sufzoli/suf-electronics-fc002/FC002B (Production PCB)/Documentation/PIC/FC002_conn.jpg

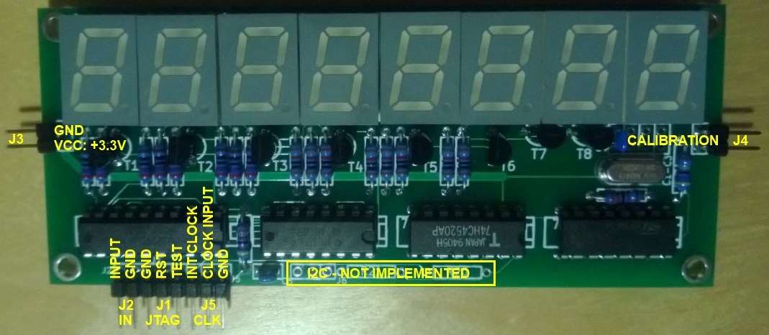
FC002B (Production PCB)/Documentation/PIC/FC002_conn.jpg
