sufzoli/suf-electronics-fc002/FC002B (Production PCB)/Documentation/PIC/FC002_small.jpg

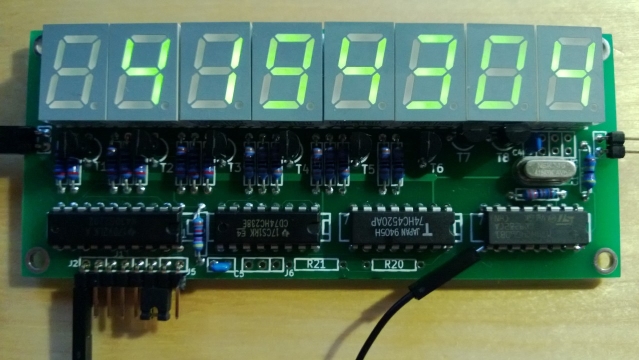
FC002B (Production PCB)/Documentation/PIC/FC002_small.jpg
