sufzoli/suf-electronics-fc002/README.md

electronics-fc002
=================

MSP430 Based Simple Frequency Counter
