sufzoli/suf-electronics-fc002/Documentation/FC003-conn.jpg

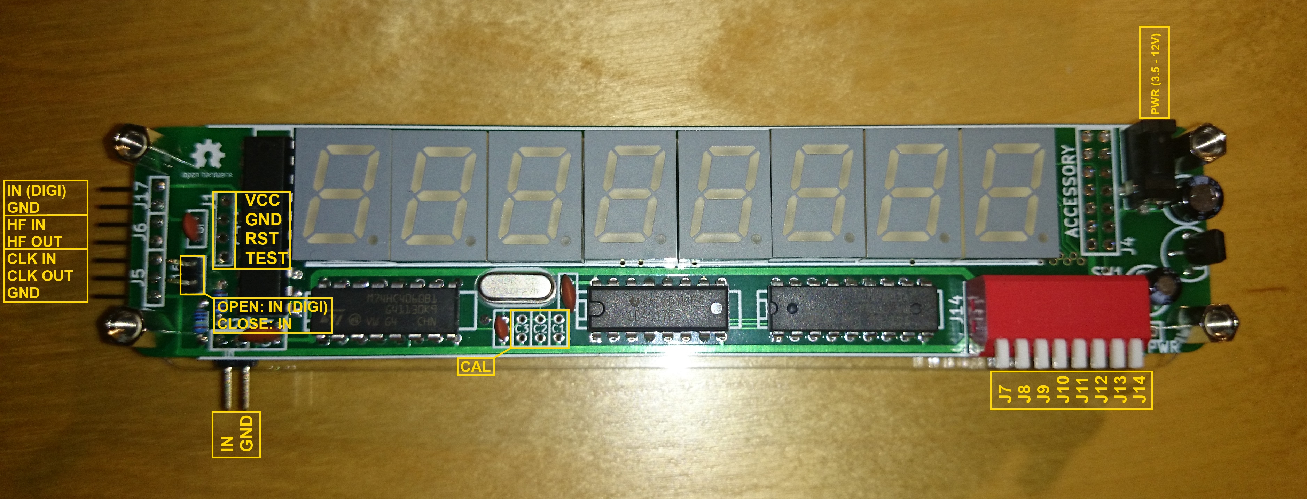
Documentation/FC003-conn.jpg
