sufzoli/suf-electronics-fc002/Documentation/Launchpad.jpg

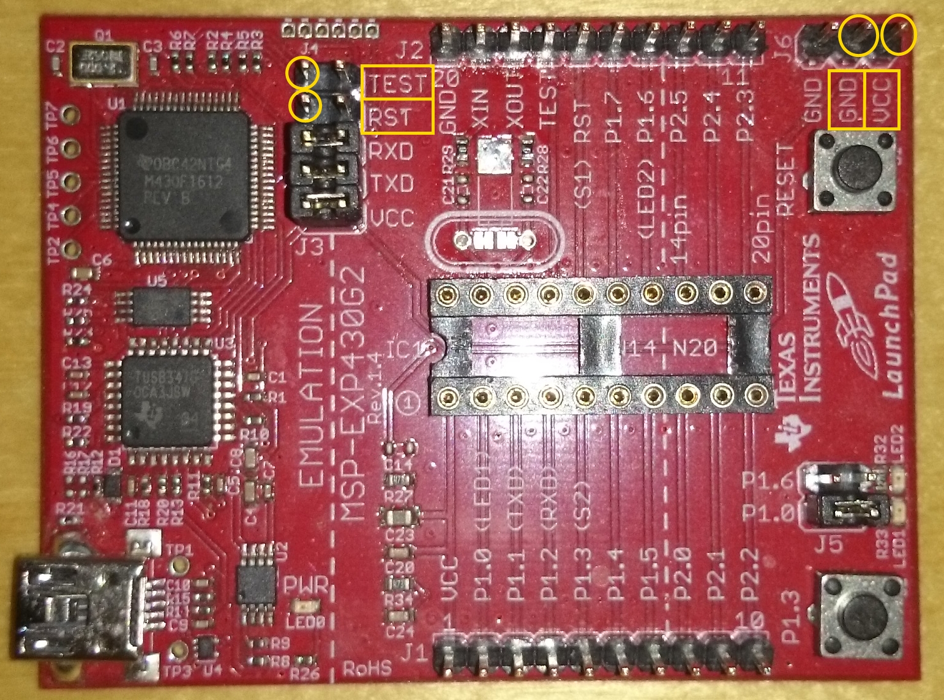
Documentation/Launchpad.jpg
