sufzoli/suf-electronics-fc002/Documentation/page3.gif

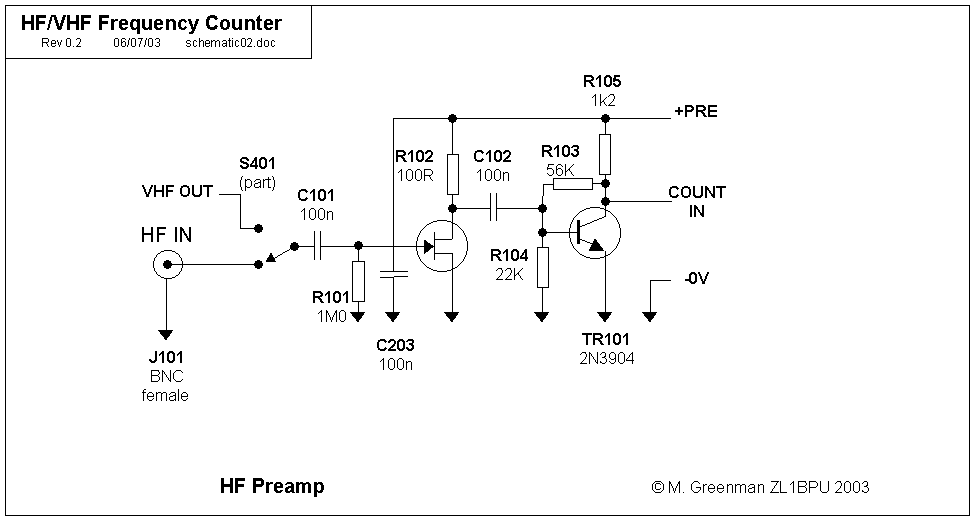
Documentation/page3.gif
