sufzoli/suf-electronics-fc002/Documentation/FC002_component_cost_HUF.xlsx

Sheet: FR002
REF | Value
C1
C2
C3
C4 | 82pF
C5 | 1nF
IC1 | MSP430G2202
IC2 | 74HC238
IC3 | 74HC4060
IC4 | 74HC4520
IC5 | SC52-11
IC6 | SC52-11
IC7 | SC52-11
IC8 | SC52-11
IC9 | SC52-11
IC10 | SC52-11
IC11 | SC52-11
IC12 | SC52-11
J1 | 3 pin Header
J2 | 2 pin Header
J3 | 2 pin Header
J4 | 2 pin Header
J5 | 3 pin Header
R1 | 4M7
R2 | 2K2
R3 | 47K
R4 | 10K
R5 | 10K
R6 | 10K
R7 | 10K
R8 | 10K
R9 | 10K
R10 | 10K
R11 | 10K
R12 | 270
R13 | 270
R14 | 270
R15 | 270
R16 | 270
R17 | 270
R18 | 270
T1 | MPSA43
T2 | MPSA43
T3 | MPSA43
T4 | MPSA43
T5 | MPSA43
T6 | MPSA43
T7 | MPSA43
T8 | MPSA43
X1 | XTAL 4.194304MHz

Sheet: Sheet1
Referencia | Érték | DB | Gyártó | Típus | Beszállító | Kód | Egységár | Ár
C1-C3 | 22pF | 1 | Shinny-Space | SSM15N220J50C | Lomex | 07-09-66 | 10.82 Ft | 10.82 Ft
C4 | 82pF | 1 | Shinny-Space | SSM15N820J50C | Lomex | 07-09-70 | 10.95 Ft | 10.95 Ft
C5 | 1nF | 1 | Shinny-Space | SSM15X102K50C | Lomex | 07-03-31 | 10.41 Ft | 10.41 Ft
IC1 | MSP430G2202 | 1 | Texas Instruments | MSP430G2202IN20 | Farnell | 1866857 | 216.55 Ft | 216.55 Ft
IC2 | 74HC238 | 1 | Texas Instruments | CD74HC238E | Lomex | 30-04-55 | 69.09 Ft | 69.09 Ft
IC3 | 74HC4060 | 1 | ST Microelectronic | M74HC4060B1R | Lomex | 30-04-20 | 79.76 Ft | 79.76 Ft
IC4 | 74HC4520 | 1 | Toshiba | TC74HC4520AP | Lomex | 30-05-27 | 18.41 Ft | 18.41 Ft
IC5-IC12 | SC52-11 | 8 | Kingbright | SC52-11GWA | Lomex | 35-00-04 | 51.47 Ft | 411.76 Ft
J1-J5 | 12 pin tüskesor | 1 | T&T Connection | PHSR-40 | Lomex | 43-00-47 | 75.35 Ft | 75.35 Ft
R1 | 4M7 | 1 | Yageo | MF0207 4M70 1% | Lomex | 02-06-93 | 8.95 Ft | 8.95 Ft
R2 | 2K2 | 1 | Yageo | MF0207 2K20 1% | Lomex | 02-01-51 | 6.95 Ft | 6.95 Ft
R3 | 47K | 1 | Yageo | MF0207 47K0 1% | Lomex | 02-01-83 | 6.95 Ft | 6.95 Ft
R4-R11 | 10K | 8 | Yageo | MF0207 10K0 1% | Lomex | 02-01-67 | 2.5 Ft | 20 Ft
R12-R18 | 270R | 7 | Yageo | MF0207 270R 1% | Lomex | 02-01-29 | 2.59 Ft | 18.13 Ft
T1-T8 | MPSA43 | 8 | Motorola | MPSA43 | Lomex | 21-05-15 | 6.77 Ft | 54.16 Ft
X1 | XTAL 4.194304MHz | 1 | Jenjaan Quartek | HC49/S 4.194304MHz | Lomex | 40-01-33 | 46.42 Ft | 46.42 Ft
 |  |  |  |  |  |  |  | 1064.66 Ft
