sufzoli/suf-electronics-fc002/Documentation/FC003_cost.xlsx

Sheet: FC003
 |  | Required component
C1 |  | none
C2 |  | none
C3 |  | none
C4 | 82pF
C5 | 1nF
C6 | 100nF
C7 | 100nF
C8 | 100uF/16V
C9 | 22uF/16V
D1 | 1N4148
D2 | 1N4148
D3 | 1N4148
D4 | 1N4148
D5 | 1N4148
D6 | 1N4148
D7 | 1N4148
D8 | 1N4148
D9 | 1N4148
D10 | 1N4148
J1 | SBW | none
J2 | IN | 90M | 2
J3 | PWR | 90M | 2
J4 | ACCESSORY | F | 7x2
J5 | EXT CLK | 90M | 3 | F
J6 | HF SRC | 90M | 2 | F
J7-J14 | JUMPER Block | 90M | 2x8 | F
J15 | PSU
J16 | EN_PR | M | 2
J17 | IN_DIG | 90M | 2 | F
R1 | 4M7
R2 | 2K2
R3 | 47K
R4 | 1M
R5 | 10K
R12 | 100
R13 | 100
R14 | 100
R15 | 100
R16 | 100
R17 | 100
R18 | 100
R19 | 100
SW1 | DIPSW-8
U1 | MSP430G2202
U2 | CD4017
U3 | 74HC4060
U4 | ULN2803A
U5 | SC52-11
U6 | SC52-11
U7 | SC52-11
U8 | SC52-11
U9 | SC52-11
U10 | SC52-11
U11 | SC52-11
U12 | SC52-11
U13 | TS2950CT
X1 | 4.194304MHz

Sheet: Sheet1
db | 50 |  | Lomex |  |  | TME |  |  | Farnell |  | eBay
C4 | 82pF | 1 |  | 4.62 | 4.62 |  | 2.728 |  |  |  |  | TME/Home
C5 | 1nF | 1 |  | 5.9 | 5.9 |  | 2.138 |  |  |  |  | TME/Home
C6-C7 | 100nF | 2 |  | 5.5 | 11 |  | 2.876 |  |  |  |  | TME/Home
C8 | 100uF/16V | 1 |  | 9.5 | 9.5 |  |  |  |  |  |  | Lomex
C9 | 22uF/16V | 1 |  | 8.2 | 8.2 |  | 6.932 |  |  |  |  | TME/Lomex
D1-D10 | 1N4148 | 10 |  | 1.64 | 16.4 |  | 1.103 |  |  |  |  | TME
J15 | PSU | 1 |  | 31.3 | 31.3 |  |  |  |  |  |  | ?
R1 | 4M7 | 1 |  | 3.45 | 3.45 |  |  |  |  |  |  | Lomex
R2 | 2K2 | 1 |  | 2.7 | 2.7 |  |  |  |  |  |  | Lomex
R3 | 47K | 1 |  | 2.7 | 2.7 |  |  |  |  |  |  | Lomex
R4 | 1M | 1 |  | 2.7 | 2.7 |  |  |  |  |  |  | Lomex
R5 | 1K | 1 |  | 2.7 | 2.7 |  |  |  |  |  |  | Lomex
R12-R19 | 100 | 8 |  | 2.38 | 19.04 |  |  |  |  |  |  | Lomex
SW1 | DIPSW-8 | 1 |  | 137.14 | 137.14 |  | 161.493 |  |  |  |  | Lomex
U1 | MSP430G2312 | 1 |  |  | 0 |  |  |  |  | 213.32 |  | Farnell
U2 | CD4017 | 1 |  | 38.5 | 38.5 |  | 38.729 |  |  |  |  | Lomex
U3 | 74HC4060 | 1 |  | 61.89 | 61.89 |  | 41.855 |  |  |  |  | TME
U4 | ULN2803A | 1 |  | 89.65 | 89.65 |  | 70.821 |  |  |  |  | TME
U5-U13 | SC52-11 | 8 |  | 40.53 | 324.24 |  | 159.527 |  |  |  |  | Lomex
U13 | TS2950CT-3.3 | 1 |  | 37.34 | 37.34 |  | 21.297 | L78L33ABZ |  |  |  | TME | Ellenőrizni a bekötést
X1 | 4.194304MHz | 1 |  | 35.8 | 35.8 |  | 21.311 |  |  |  |  |  | Várni a tesztig (elmegy-e 16MHz-ről)
 |  |  |  |  | 844.77
J2,J3,J5,J6,J17 | Header 90M | 0.275 | 13.75 | 15.38 |  |  |  |  |  |  |  |  |  | 15 db ára osztva 50-el
J5,J6,J17 | Header F 1x7 | 1 | 50.00 |  |  |  | 30.862 | ZL262-7SG |  |  |  | TME
J7-14 | Header 90M dual | 0.2 | 10.00 | 21.8
J7-14 | Header F 2x8 | 1 | 50.00 |  |  |  | 54.32 | ZL262-16DG |  |  |  | TME
J4 | Header F 2x7 | 1 | 50.00 |  |  |  | 28.658 | ZL262-14DG |  |  |  | TME
J16 | Header 2 M | 0.05 | 2.50 |  |  |  |  |  |  |  |  |  |  | Home
 | Jumper | 3 | 150.00 | 2.27
