sufzoli/suf-electronics-fc002/FC002B v2 (Home PCB)/KiCAD/FC002B_BOM.xlsx

ref | value | ref | value
C1 | C | R4 | 4K7
C2 | C | R5 | 4K7
C3 | C | R6 | 4K7
C4 | 82pF | R7 | 4K7
C5 | 1nF | R8 | 4K7
D1 | 1N4148 | R9 | 4K7
D2 | 1N4148 | R10 | 4K7
IC1 | MSP430G2202 | R11 | 4K7
IC2 | 74HC238 | R12 | 270
IC3 | 74HC4060 | R13 | 270
IC4 | 74HC4520 | R14 | 270
IC5 | SC52-11 | R15 | 270
IC6 | SC52-11 | R16 | 270
IC7 | SC52-11 | R17 | 270
IC8 | SC52-11 | R18 | 270
IC9 | SC52-11 | R19 | 1M
IC10 | SC52-11 | R20 | 10k
IC11 | SC52-11 | T1 | MPSA43
IC12 | SC52-11 | T2 | MPSA43
J1 | JTAG | T3 | MPSA43
J2 | IN | T4 | MPSA43
J3 | PWR | T5 | MPSA43
J4 | CAL | T6 | MPSA43
J5 | EXT CLK | T7 | MPSA43
R1 | 4M7 | T8 | MPSA43
R2 | 2K2 | X1 | 4.194304MHz
R3 | 47K
