sufzoli/suf-electronics-fc002/FC003 (Production PCB)/KiCAD/GERBER_SOB/FC003_SOB-Edge_Cuts.dxf

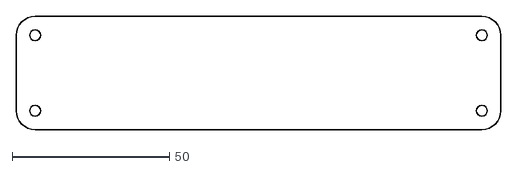
[picture p7: CAD file, 2014-01-21]
FC003 (Production PCB)/KiCAD/GERBER_SOB/FC003_SOB-Edge_Cuts.dxf
154.0 x 36.0
