sufzoli/suf-electronics-fc002/Documentation/FC002B v2 (Home) Schematic.pdf

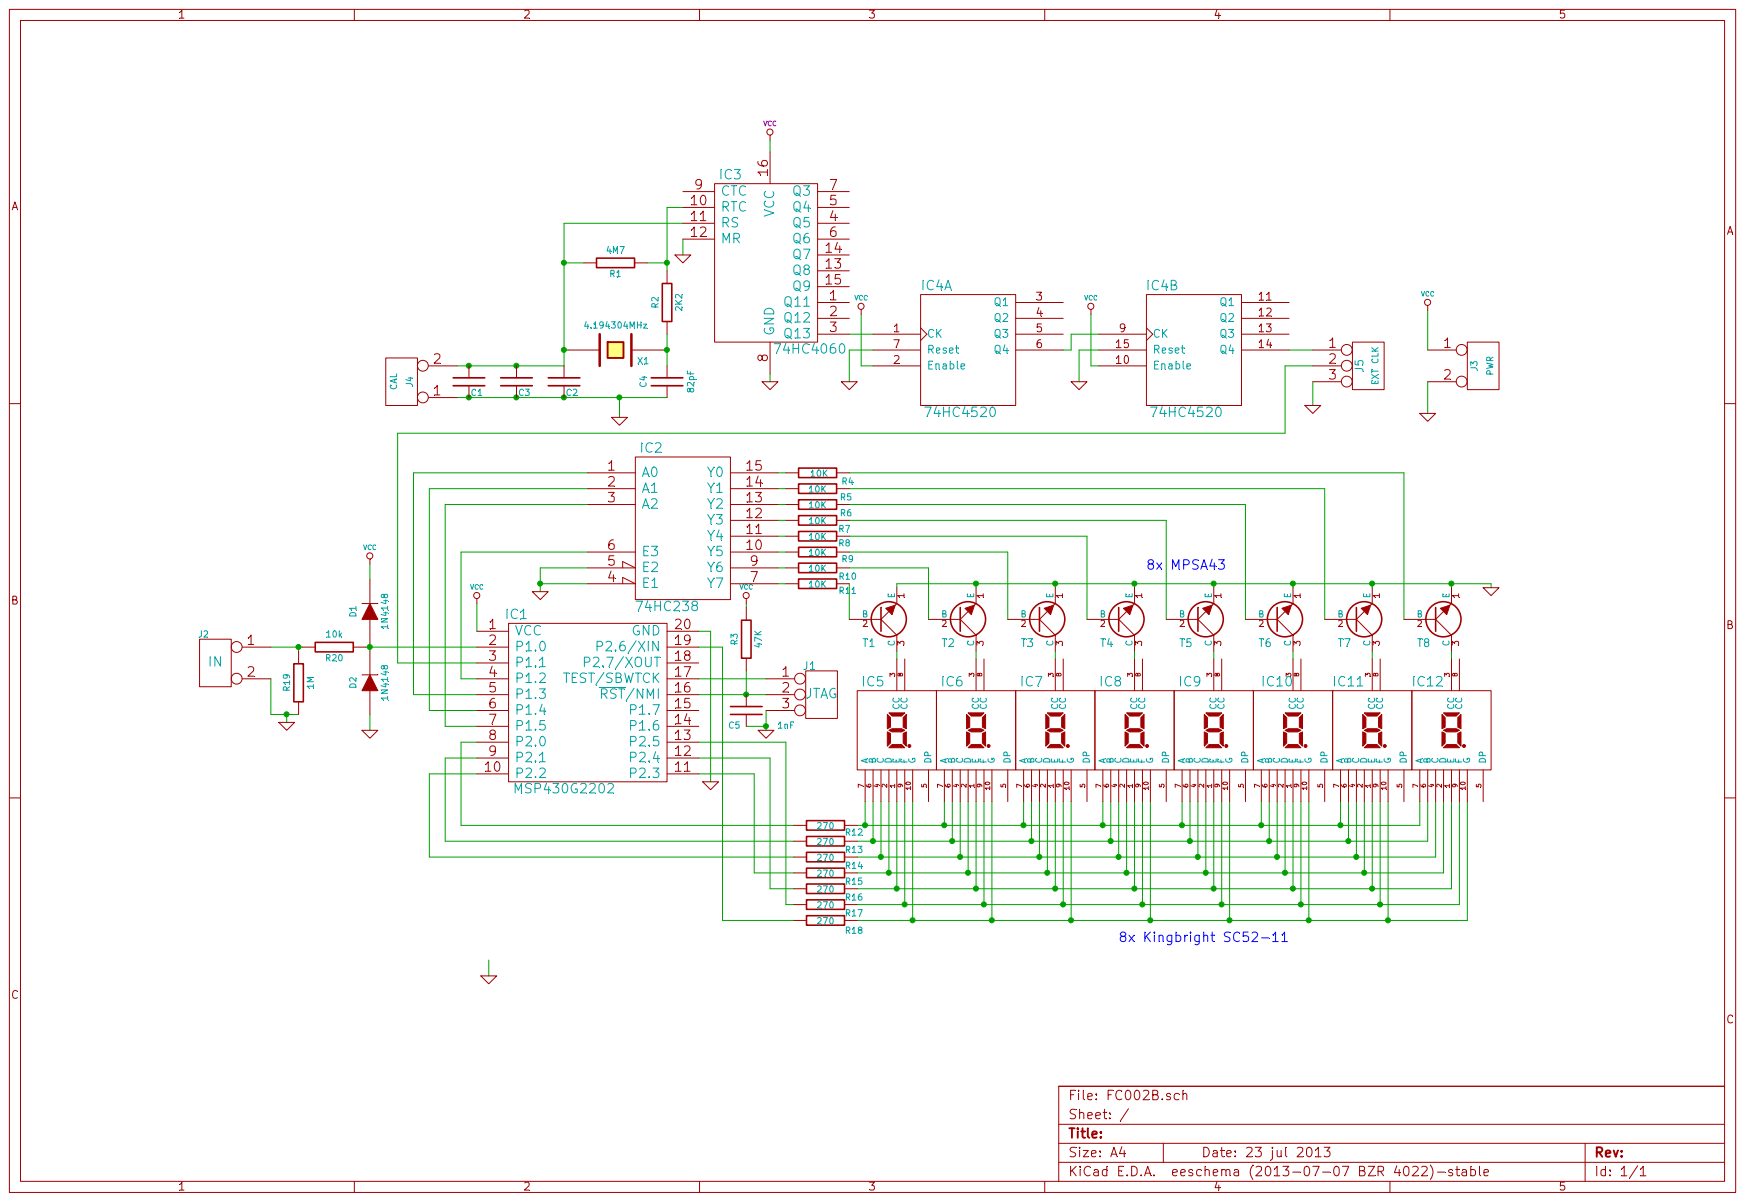
[picture p10: page 1]
