sufzoli/suf-electronics-fc002/FC002B (Production PCB)/Files/FC002_Schematic_Pro.pdf

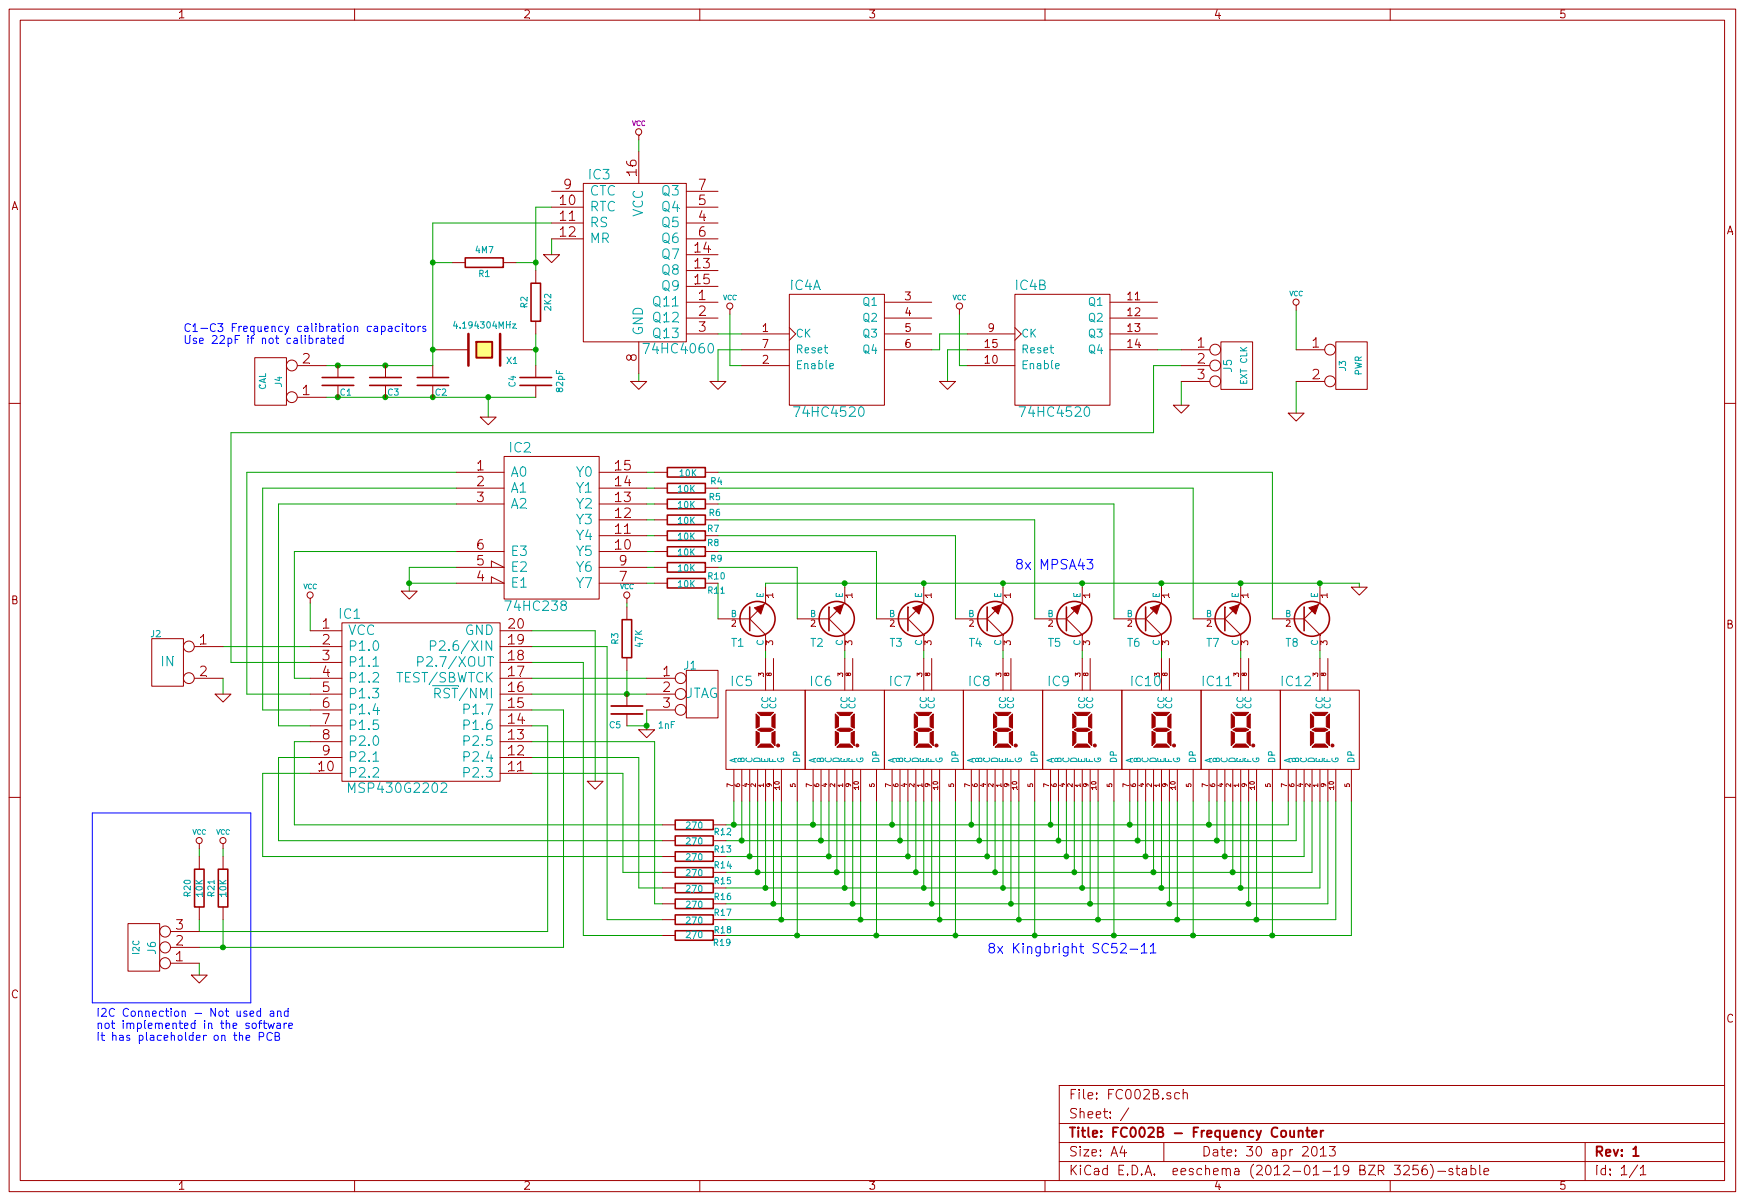
[picture p11: page 1]
