sufzoli/suf-electronics-fc002/FC003 (Home PCB)/KiCAD/GERBER/FC003_print-Back.pdf

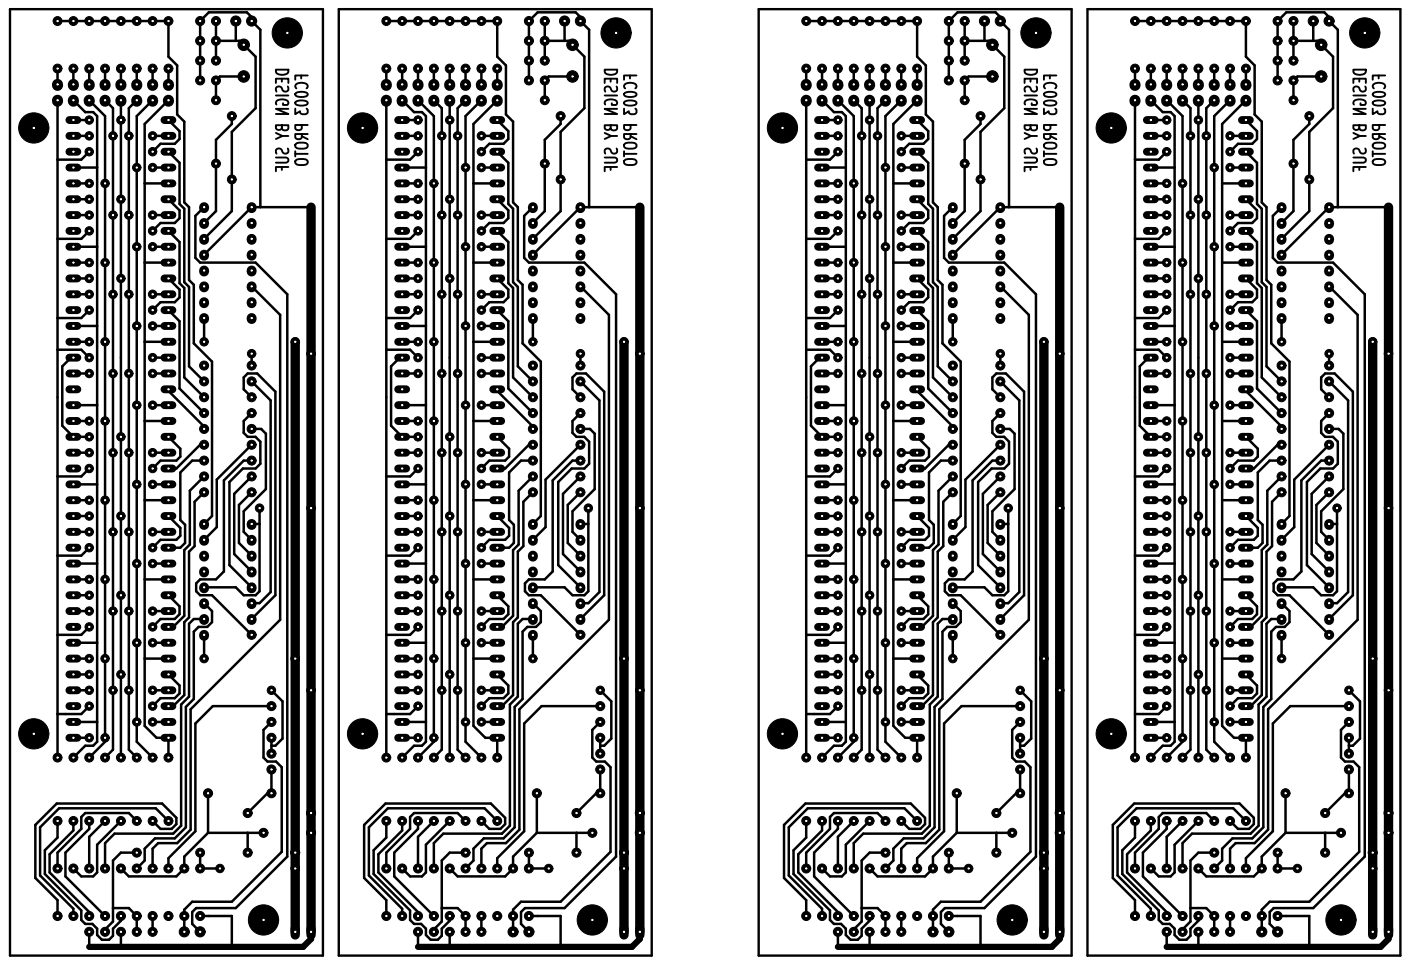
[picture p12: page 1]
