sufzoli/suf-electronics-fc002/Documentation/FC003_sch.pdf

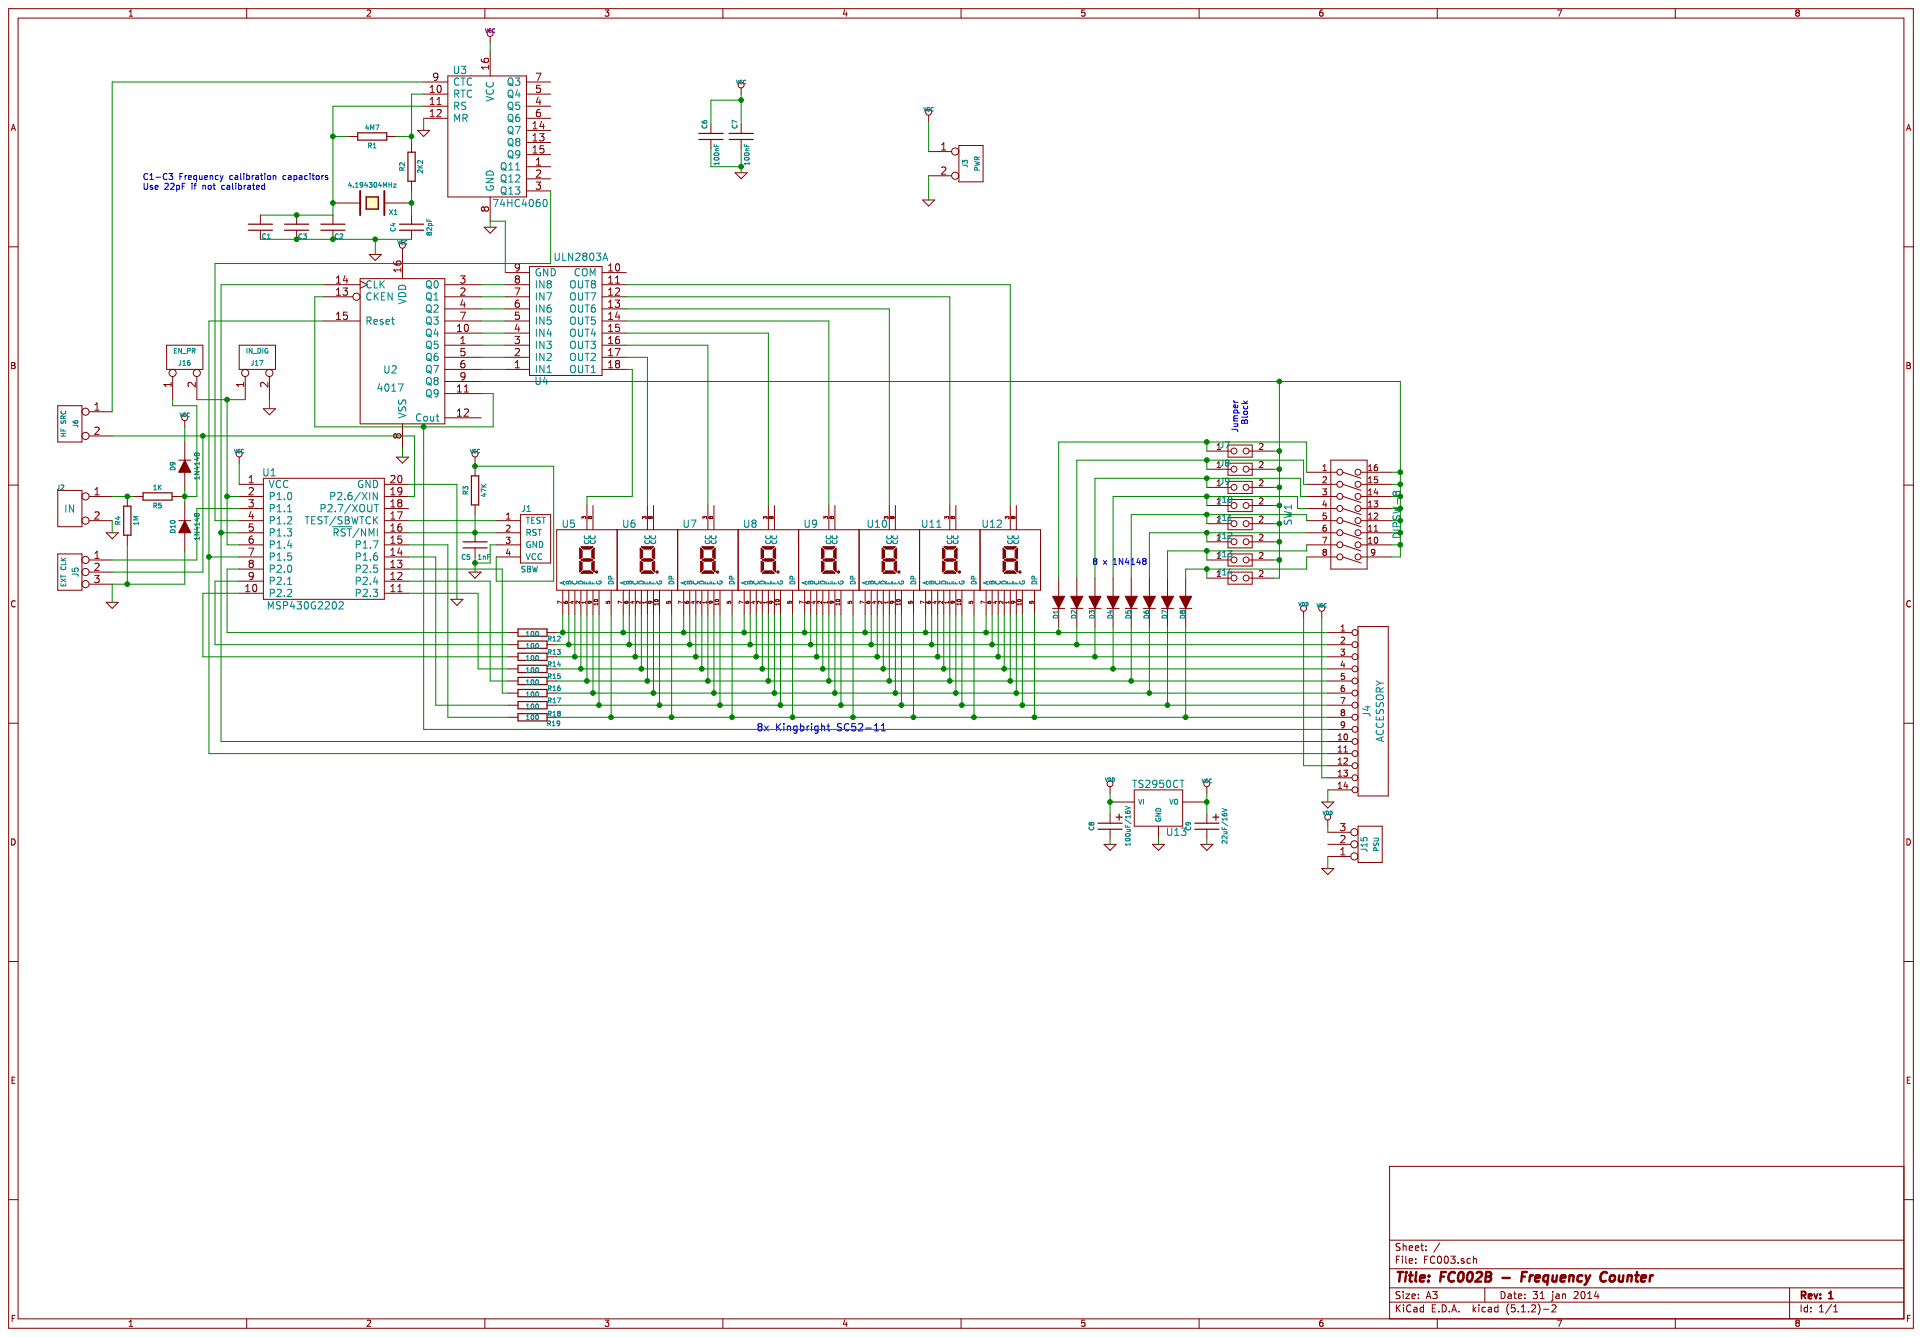
[picture p13: page 1]
