sufzoli/suf-electronics-fc002/Documentation/FC002B v2 (Home) PCB Back.pdf

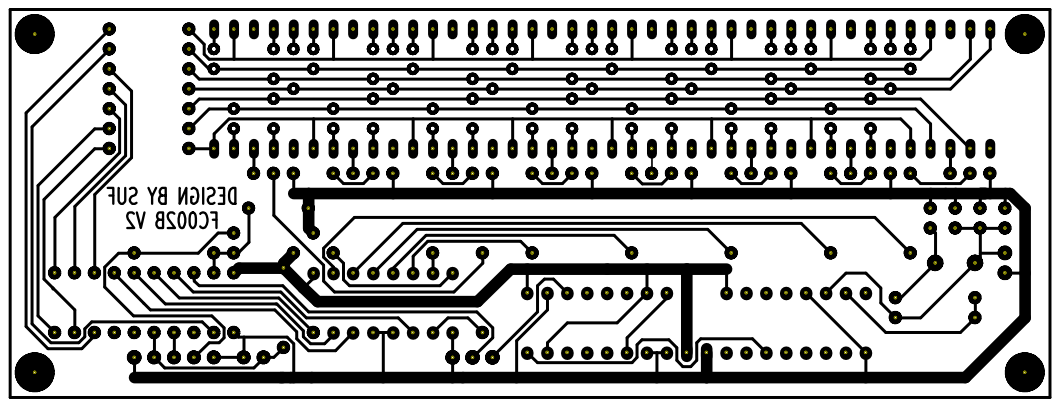
[picture p14: page 1]
