sufzoli/suf-electronics-fc002/FC003 (Production PCB)/KiCAD/GERBER_SOB/FC003_SOB-Edge_Cuts.pdf

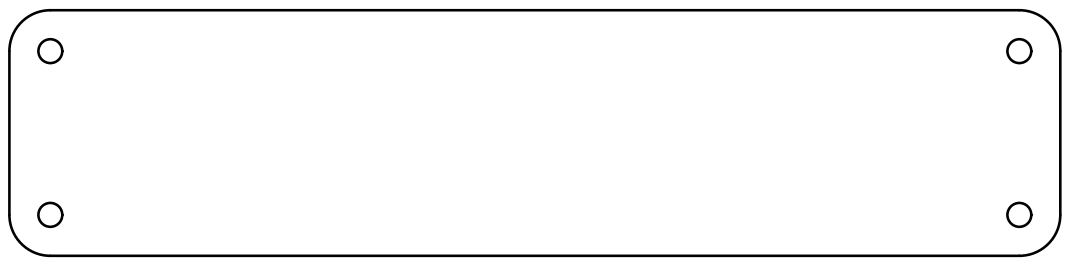
[picture p15: page 1]
