sufzoli/suf-electronics-fc002/FC002B (Home PCB)/Files/component.pdf

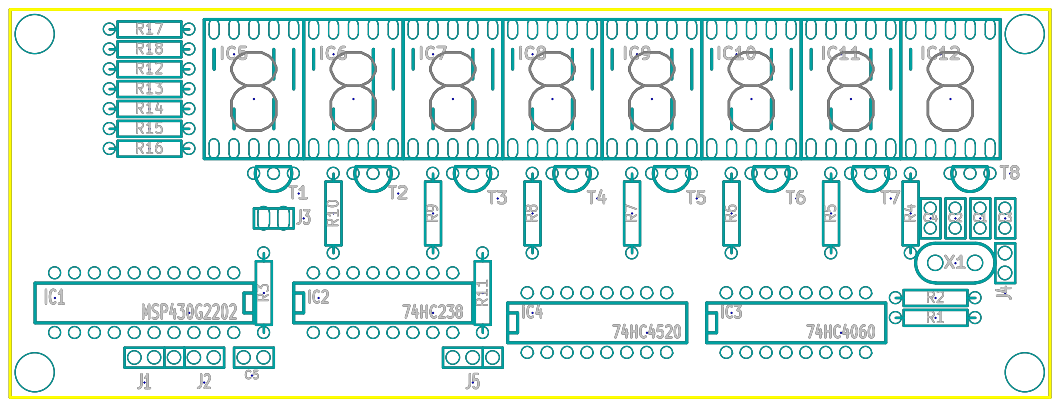
[picture p16: page 1]
