sufzoli/suf-electronics-fc002/FC002B (Home PCB)/Files/schematic.pdf

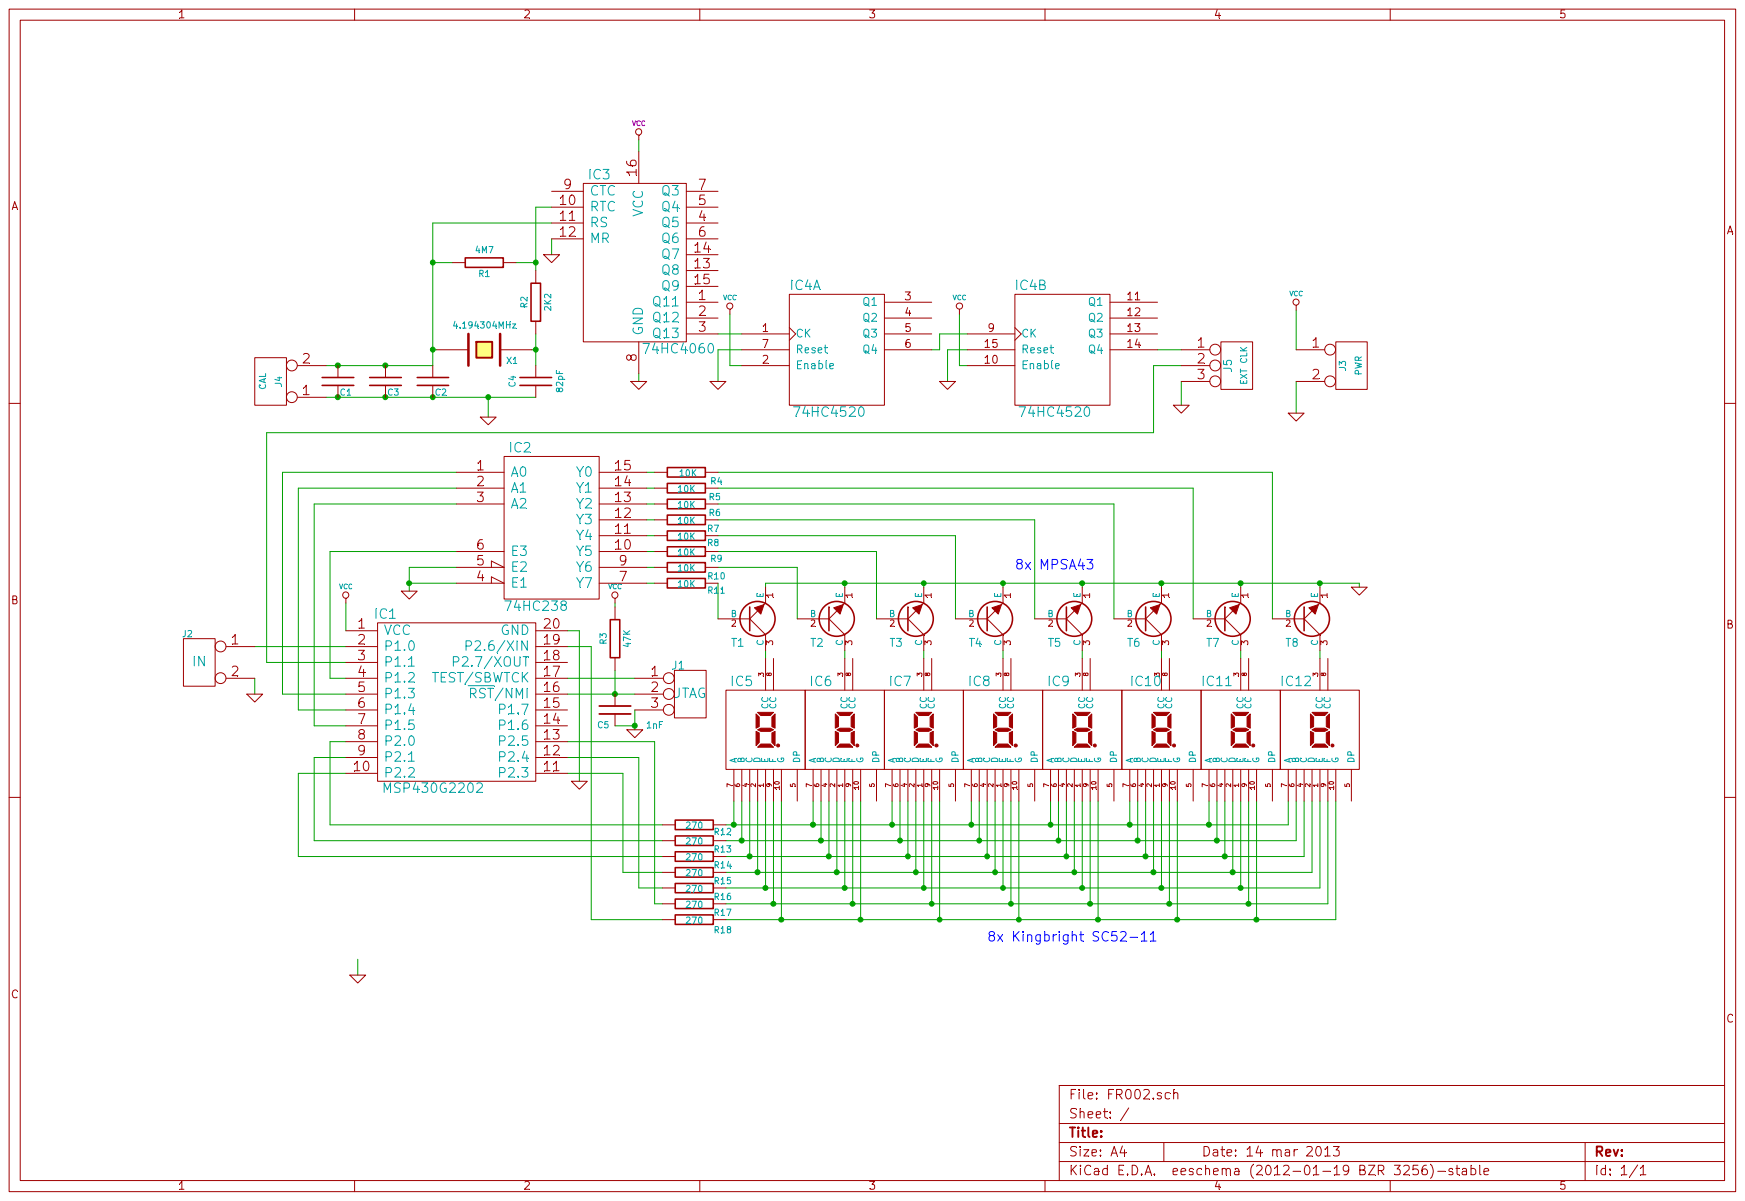
[picture p17: page 1]
