sufzoli/suf-electronics-fc002/FC002B (Home PCB)/Files/PCB.pdf

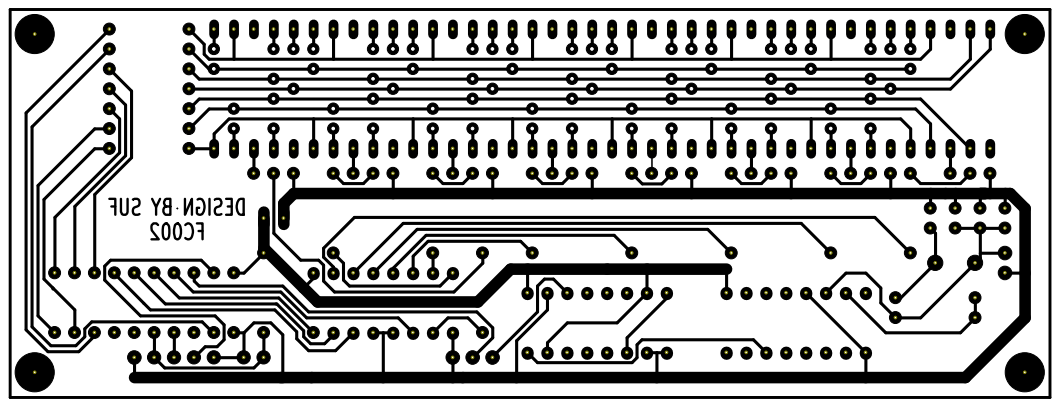
[picture p18: page 1]
