sufzoli/suf-electronics-fc002/FC003_Input/FC003_Input.kicad_pcb

## KiCad design FC003_Input/FC003_Input.kicad_pcb (2014-10-11)

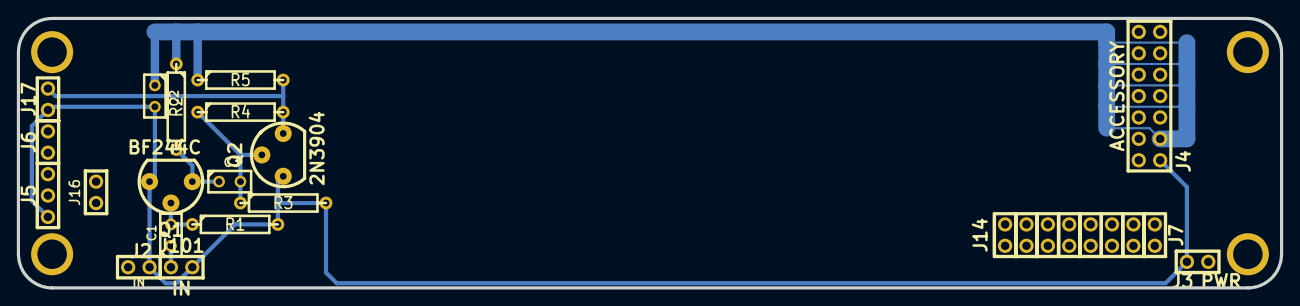
[picture p19: board FC003_Input.kicad_pcb from above]

Board: 2 copper layers, 150.0 x 32.0 mm, 30 parts (0 on the bottom side), 7 nets.

Parts:
C1, C2, C3: 100n; C1
J2, J101: IN; HDR-2
J3: PWR; HDR-2
J4: ACCESSORY; HDR-7x2
J5: EXT CLK; HDR-3
J6: HF SRC; HDR-2
J7, J8, J9, J10, J11, J12, J13, J14: HDR-2
J16: EN_PR; HDR-2
J17: OUT; HDR-2
MNT_HOLE_3.5S, MNT_HOLE_3.5S#2, MNT_HOLE_3.5S#3, MNT_HOLE_3.5S#4: Val**; MNT_HOLE_3.5S
Q1: BF244C; TO-92_V
Q2: 2N3904; TO-92_V
R1: 1M; R4
R2: 100; R4
R3: 22K; R4
R4: 56K; R4
R5: 1K2; R4

Connections:
GND: C2.2, J2.2, J3.2, J4.14, J5.3, J17.2, J101.2, Q1.3, Q2.1, R1.2, R3.2
unnamed: J17.1, Q2.3, R4.2, R5.2
unnamed: C3.1, Q1.1, R2.2
unnamed: C3.2, Q2.2, R3.1, R4.1
unnamed: C1.1, J101.1
unnamed: C1.2, Q1.2, R1.1
VDD: C2.1, J4.12, R2.1, R5.1
