sufzoli/suf-electronics-fc002/FC003 (Production PCB)/KiCAD/FC003.kicad_pcb

## KiCad design FC003 (Production PCB)/KiCAD/FC003.kicad_pcb (2014-01-21)

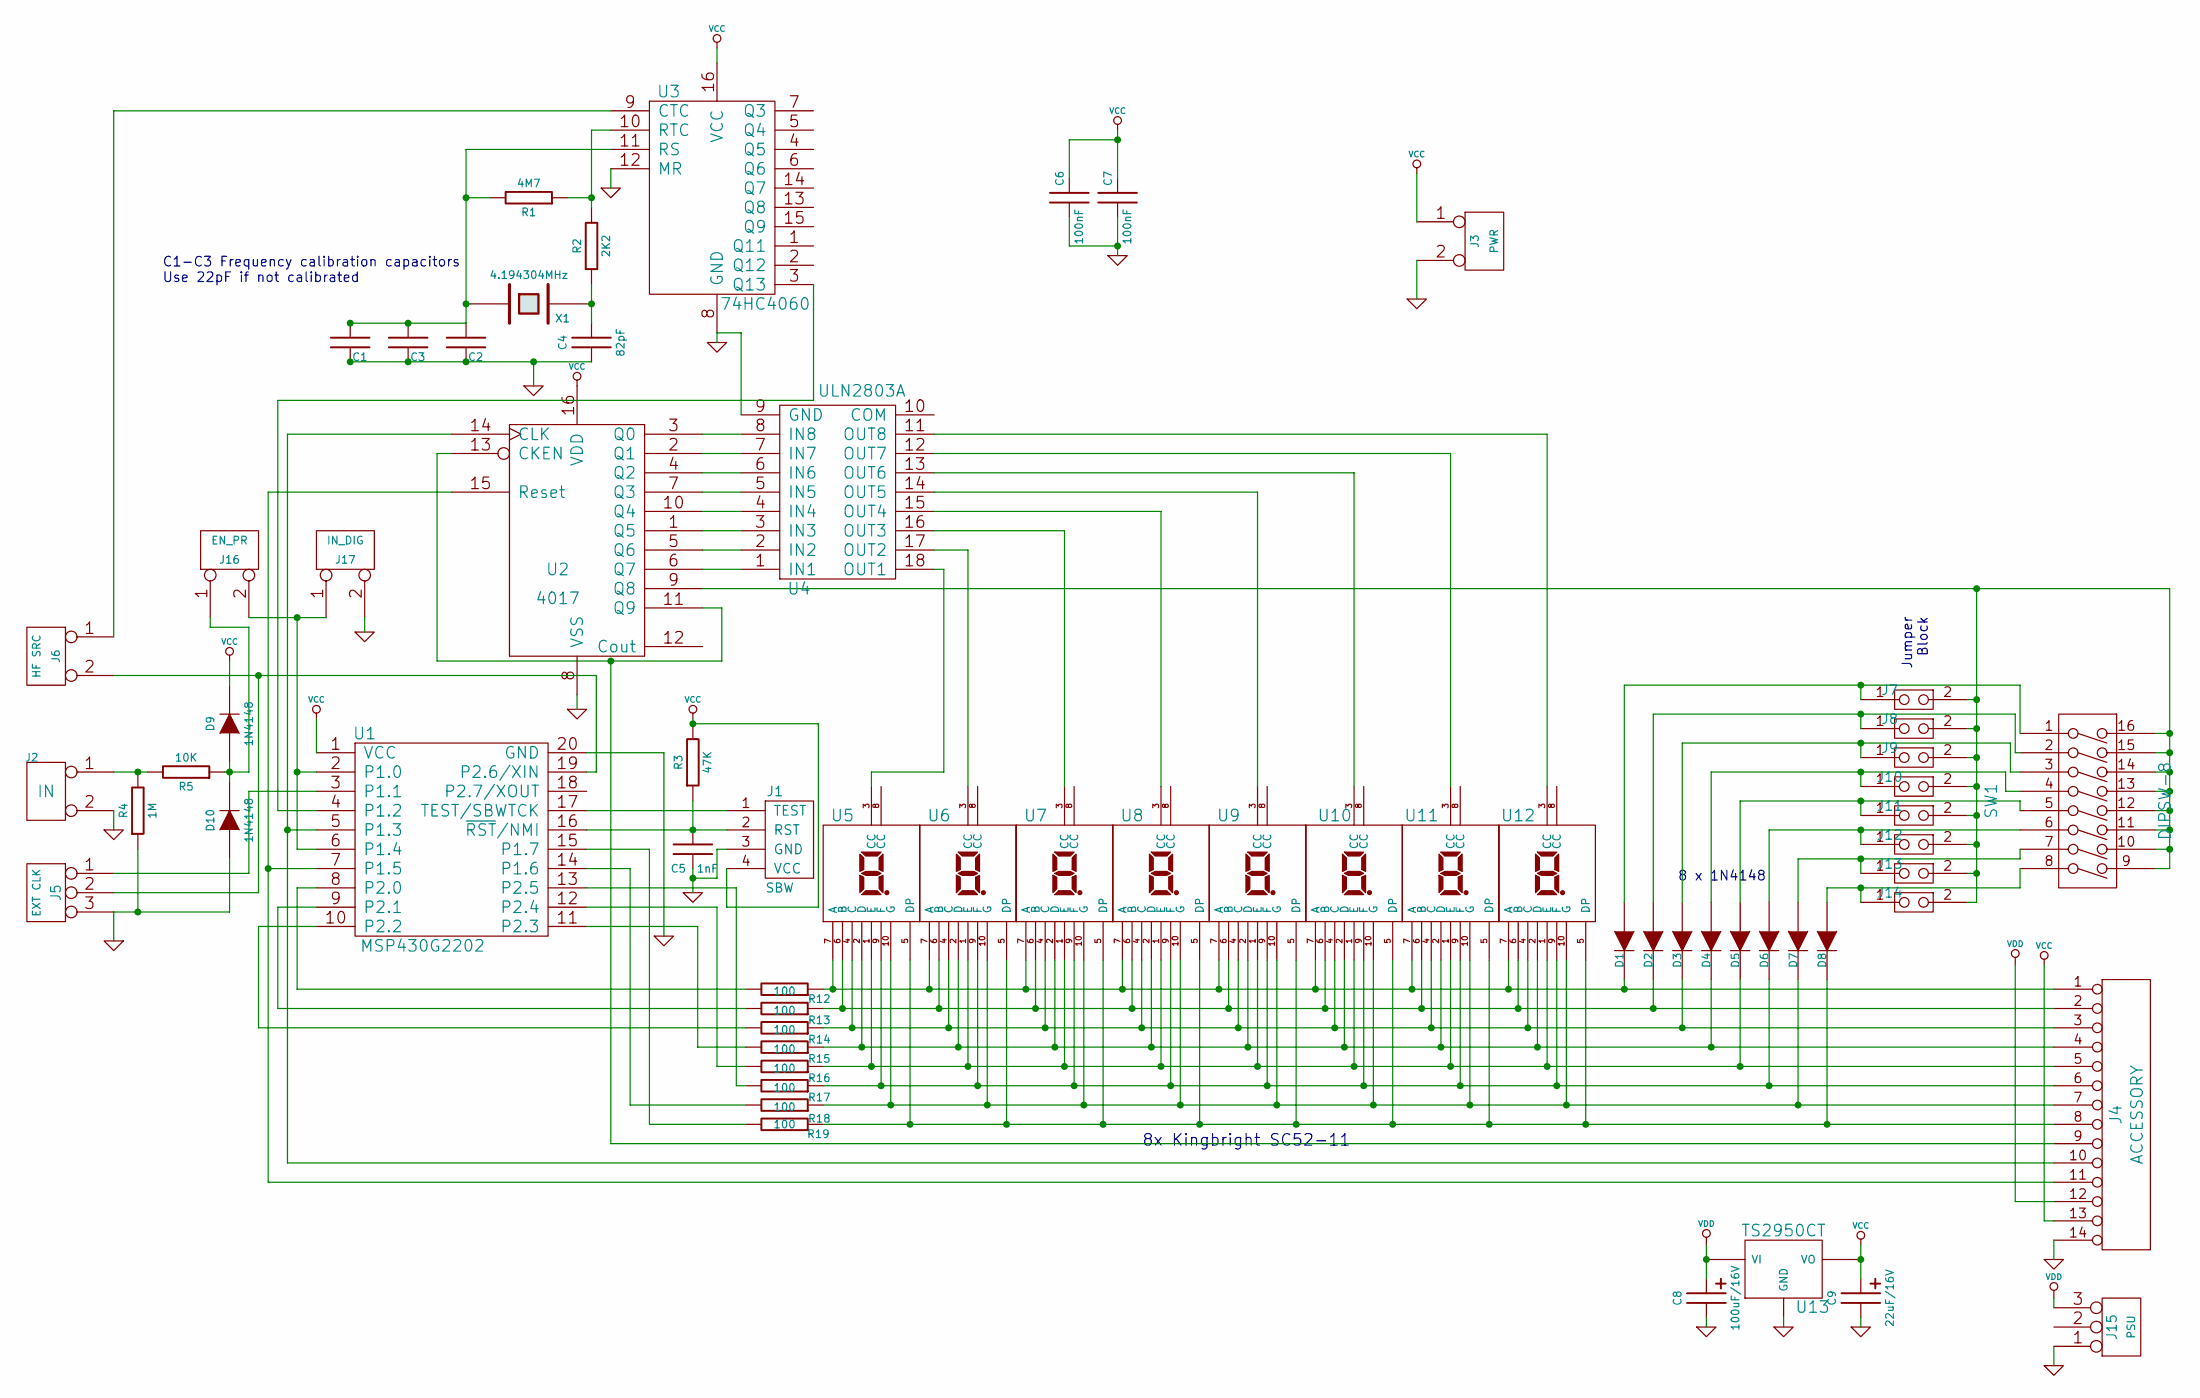
[picture p20: schematic FC003.sch, FC002B - Frequency Counter]

Parts:
C1, C2, C3: C; C1
C4: 82pF; C1
C5: 1nF; C1
C6, C7: 100nF; C1
C8: 100uF/16V; C1P_D2.7
C9: 22uF/16V; C1P_D2.7
D1, D2, D3, D4, D5, D6, D7, D8: D2
D9, D10: 1N4148; D2
J1: SBW; HDR-TI-SBW
J2: IN; HDR-2
J3: PWR; HDR-2
J4: ACCESSORY; HDR-7x2
J5: EXT CLK; HDR-3
J6: HF SRC; HDR-2
J7, J8, J9, J10, J11, J12, J13, J14: HDR-2
J15: PSU; PWR_3.5
J16: EN_PR; HDR-2
J17: IN_DIG; HDR-2
R1: 4M7; R2
R2: 2K2; R2
R3: 47K; R2
R4: 1M; R2
R5: 10K; R2
R12, R13, R14, R15, R16, R17, R18, R19: 100; R2
SW1: DIPSW-8
U1: MSP430G2202; DIP-20__300
U2: 4017; DIP-16__300
U3: 74HC4060; DIP-16__300
U4: ULN2803A; DIP-18__300
U5, U6, U7, U8, U9, U10, U11, U12: SC52-11; Kingbright_SC52-11_S
U13: TS2950CT; TO-92_V
X1: 4.194304MHz; XTAL_MHz

Connections:
GND: C1.2, C2.2, C3.2, C4.2, C5.2, C6.2, C7.2, C8.2, C9.2, D10.1 (A), J1.3 (GND), J2.2 (PM), J3.2 (PM), J4.14, J5.3, J15.1, J17.2 (PM), R4.2, U1.20 (GND), U2.8 (VSS), U3.8 (GND), U3.12 (MR), U4.9 (GND), U13.2 (GND)
unnamed: U4.15 (OUT4), U8.3 (CC)
unnamed: U4.18 (OUT1), U5.3 (CC)
unnamed: U4.17 (OUT2), U6.3 (CC)
unnamed: U4.16 (OUT3), U7.3 (CC)
unnamed: U4.14 (OUT5), U9.3 (CC)
unnamed: U4.13 (OUT6), U10.3 (CC)
unnamed: U4.12 (OUT7), U11.3 (CC)
unnamed: U4.11 (OUT8), U12.3 (CC)
unnamed: U2.3 (Q0), U4.8 (IN8)
unnamed: U2.2 (Q1), U4.7 (IN7)
unnamed: U2.4 (Q2), U4.6 (IN6)
unnamed: R12.1, U1.8 (P2.0)
unnamed: R14.1, U1.10 (P2.2)
unnamed: R16.1, U1.12 (P2.4)
unnamed: U2.7 (Q3), U4.5 (IN5)
unnamed: J5.1, U1.3 (P1.1)
unnamed: J4.11, U1.7 (P1.5), U2.15 (Reset)
unnamed: R19.1, U1.15 (P1.7)
unnamed: R18.1, U1.14 (P1.6)
unnamed: J4.10, U1.5 (P1.3), U2.14 (CLK)
unnamed: J6.1, U3.9 (CTC)
unnamed: J5.2 (PM), J6.2 (PM), U1.19 (P2.6/XIN)
unnamed: U2.10 (Q4), U4.4 (IN4)
unnamed: U2.1 (Q5), U4.3 (IN3)
unnamed: U2.5 (Q6), U4.2 (IN2)
unnamed: U2.6 (Q7), U4.1 (IN1)
unnamed: J1.1 (TEST), U1.17 (TEST/SBWTCK)
unnamed: C4.1, R2.2, X1.2
unnamed: D4.1 (A), J10.1, SW1.4
unnamed: D5.1 (A), J11.1, SW1.5
unnamed: D1.1 (A), J7.1, SW1.1
unnamed: D2.1 (A), J8.1, SW1.2
unnamed: D3.1 (A), J9.1, SW1.3
unnamed: J16.2 (PM), J17.1, U1.2 (P1.0), U1.6 (P1.4)
unnamed: J4.9, U2.11 (Q9), U2.13 (CKEN)
unnamed: D9.1 (A), D10.2 (K), J16.1, R5.2
unnamed: D8.1 (A), J14.1, SW1.8
unnamed: D7.1 (A), J13.1, SW1.7
unnamed: D6.1 (A), J12.1, SW1.6
unnamed: D6.2 (K), J4.6, R17.2, U5.9 (F), U6.9 (F), U7.9 (F), U8.9 (F), U9.9 (F), U10.9 (F), U11.9 (F), U12.9 (F)
unnamed: J7.2, J8.2, J9.2, J10.2, J11.2, J12.2, J13.2, J14.2, SW1.9, SW1.10, SW1.11, SW1.12, SW1.13, SW1.14, SW1.15, SW1.16, U2.9 (Q8)
unnamed: D8.2 (K), J4.8, R19.2, U5.5 (DP), U6.5 (DP), U7.5 (DP), U8.5 (DP), U9.5 (DP), U10.5 (DP), U11.5 (DP), U12.5 (DP)
unnamed: R1.2, R2.1, U3.10 (RTC)
unnamed: R15.1, U1.11 (P2.3)
unnamed: U1.4 (P1.2), U3.3 (Q13)
unnamed: R13.1, U1.9 (P2.1)
unnamed: R17.1, U1.13 (P2.5)
unnamed: C5.1, J1.2 (RST), R3.2, U1.16 (~RST~/NMI)
unnamed: D5.2 (K), J4.5, R16.2, U5.1 (E), U6.1 (E), U7.1 (E), U8.1 (E), U9.1 (E), U10.1 (E), U11.1 (E), U12.1 (E)
unnamed: D7.2 (K), J4.7, R18.2, U5.10 (G), U6.10 (G), U7.10 (G), U8.10 (G), U9.10 (G), U10.10 (G), U11.10 (G), U12.10 (G)
unnamed: D2.2 (K), J4.2, R13.2, U5.6 (B), U6.6 (B), U7.6 (B), U8.6 (B), U9.6 (B), U10.6 (B), U11.6 (B), U12.6 (B)
unnamed: D4.2 (K), J4.4, R15.2, U5.2 (D), U6.2 (D), U7.2 (D), U8.2 (D), U9.2 (D), U10.2 (D), U11.2 (D), U12.2 (D)
unnamed: C1.1, C2.1, C3.1, R1.1, U3.11 (RS), X1.1
unnamed: D1.2 (K), J4.1, R12.2, U5.7 (A), U6.7 (A), U7.7 (A), U8.7 (A), U9.7 (A), U10.7 (A), U11.7 (A), U12.7 (A)
unnamed: D3.2 (K), J4.3, R14.2, U5.4 (C), U6.4 (C), U7.4 (C), U8.4 (C), U9.4 (C), U10.4 (C), U11.4 (C), U12.4 (C)
unnamed: J2.1, R4.1, R5.1
VCC: C6.1, C7.1, C9.1, D9.2 (K), J1.4 (VCC), J3.1, J4.13, R3.1, U1.1 (VCC), U2.16 (VDD), U3.16 (VCC), U13.1 (VO)
VDD: C8.1, J4.12, J15.3, U13.3 (VI)

Notes on the sheet:
C1-C3 Frequency calibration capacitors Use 22pF if not calibrated
8x Kingbright SC52-11
8 x 1N4148
Jumper Block

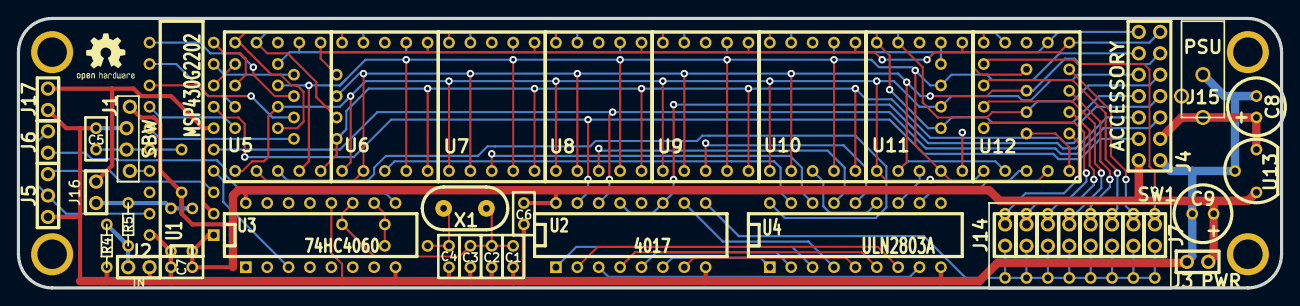
[picture p21: board FC003.kicad_pcb from above]

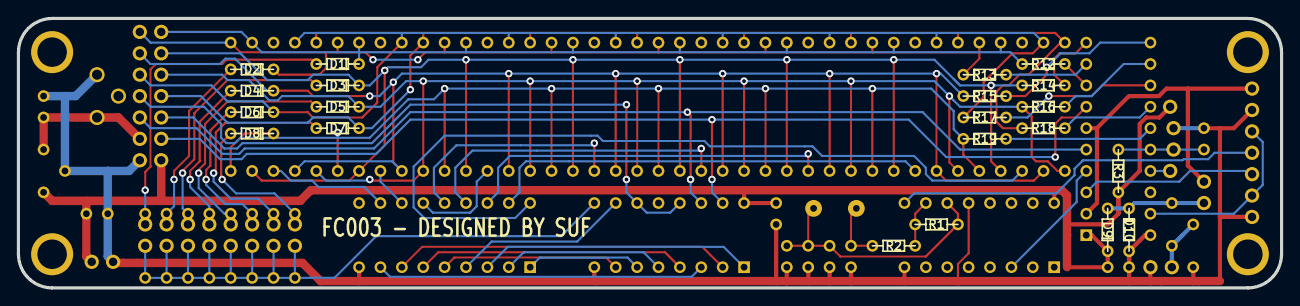
[picture p22: board FC003.kicad_pcb from below]

Board: 2 copper layers, 150.0 x 32.0 mm, 68 parts (21 on the bottom side), 59 nets.

Other parts of the board:
MNT_HOLE_3.5S, MNT_HOLE_3.5S#2, MNT_HOLE_3.5S#3, MNT_HOLE_3.5S#4: Val**; MNT_HOLE_3.5S
