sufzoli/suf-electronics-fc002/FC003_Input/FC003_template.kicad_pcb

## KiCad design FC003_Input/FC003_template.kicad_pcb (2014-10-11)

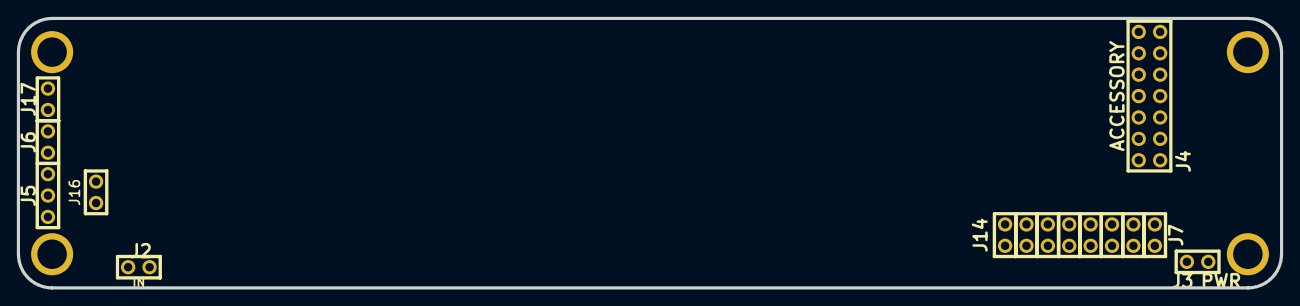
[picture p23: board FC003_template.kicad_pcb from above]

Board: 2 copper layers, 150.0 x 32.0 mm, 19 parts (0 on the bottom side), 5 nets, no tracks yet.

Parts:
J2: IN; HDR-2
J3: PWR; HDR-2
J4: ACCESSORY; HDR-7x2
J5: EXT CLK; HDR-3
J6: HF SRC; HDR-2
J7, J8, J9, J10, J11, J12, J13, J14: HDR-2
J16: EN_PR; HDR-2
J17: IN_DIG; HDR-2
MNT_HOLE_3.5S, MNT_HOLE_3.5S#2, MNT_HOLE_3.5S#3, MNT_HOLE_3.5S#4: Val**; MNT_HOLE_3.5S

Connections:
GND: J2.2, J3.2, J4.14, J5.3, J17.2
unnamed: J5.2, J6.2
unnamed: J16.2, J17.1
unnamed: J7.2, J8.2, J9.2, J10.2, J11.2, J12.2, J13.2, J14.2
VCC: J3.1, J4.13
