sufzoli/suf-electronics-fc002/FC002B (Home PCB)/KiCAD/FC002B.sch

## KiCad design FC002B (Home PCB)/KiCAD/FC002B.sch (2013-08-01, an earlier design)

Schematic: FC002B.sch

Parts:
C1, C2, C3: C; C1
C4: 82pF; C1
C5: 1nF; C1
IC1: MSP430G2202; DIP-20__300_ELL
IC2: 74HC238; DIP-16__300_ELL
IC3: 74HC4060; DIP-16__300_ELL
IC4: 74HC4520; DIP-16__300_ELL
IC5, IC6, IC7, IC8, IC9, IC10, IC11, IC12: SC52-11; Kingbright SC52-11
J1: JTAG; SIL-3-1
J2: IN; SIL-2
J3: PWR; SIL-2
J4: CAL; SIL-2
J5: EXT CLK; SIL-3-1
R1: 4M7; R4-SP
R2: 2K2; R4-SP
R3: 47K; R4-SP
R4, R5, R6, R7, R8, R9, R10, R11: 10K; R4-SP
R12, R13, R14, R15, R16, R17, R18: 270; R4-SP
T1, T2, T3, T4, T5, T6, T7, T8: MPSA43; TO-92_LIN
X1: 4.194304MHz; XTAL_MHz

Notes on the sheet:
8x MPSA43
8x Kingbright SC52-11
