sufzoli/suf-electronics-fc002/FC002B v2 (Home PCB)/KiCAD/FC002B.sch

## KiCad design FC002B v2 (Home PCB)/KiCAD/FC002B.sch (2013-11-13)

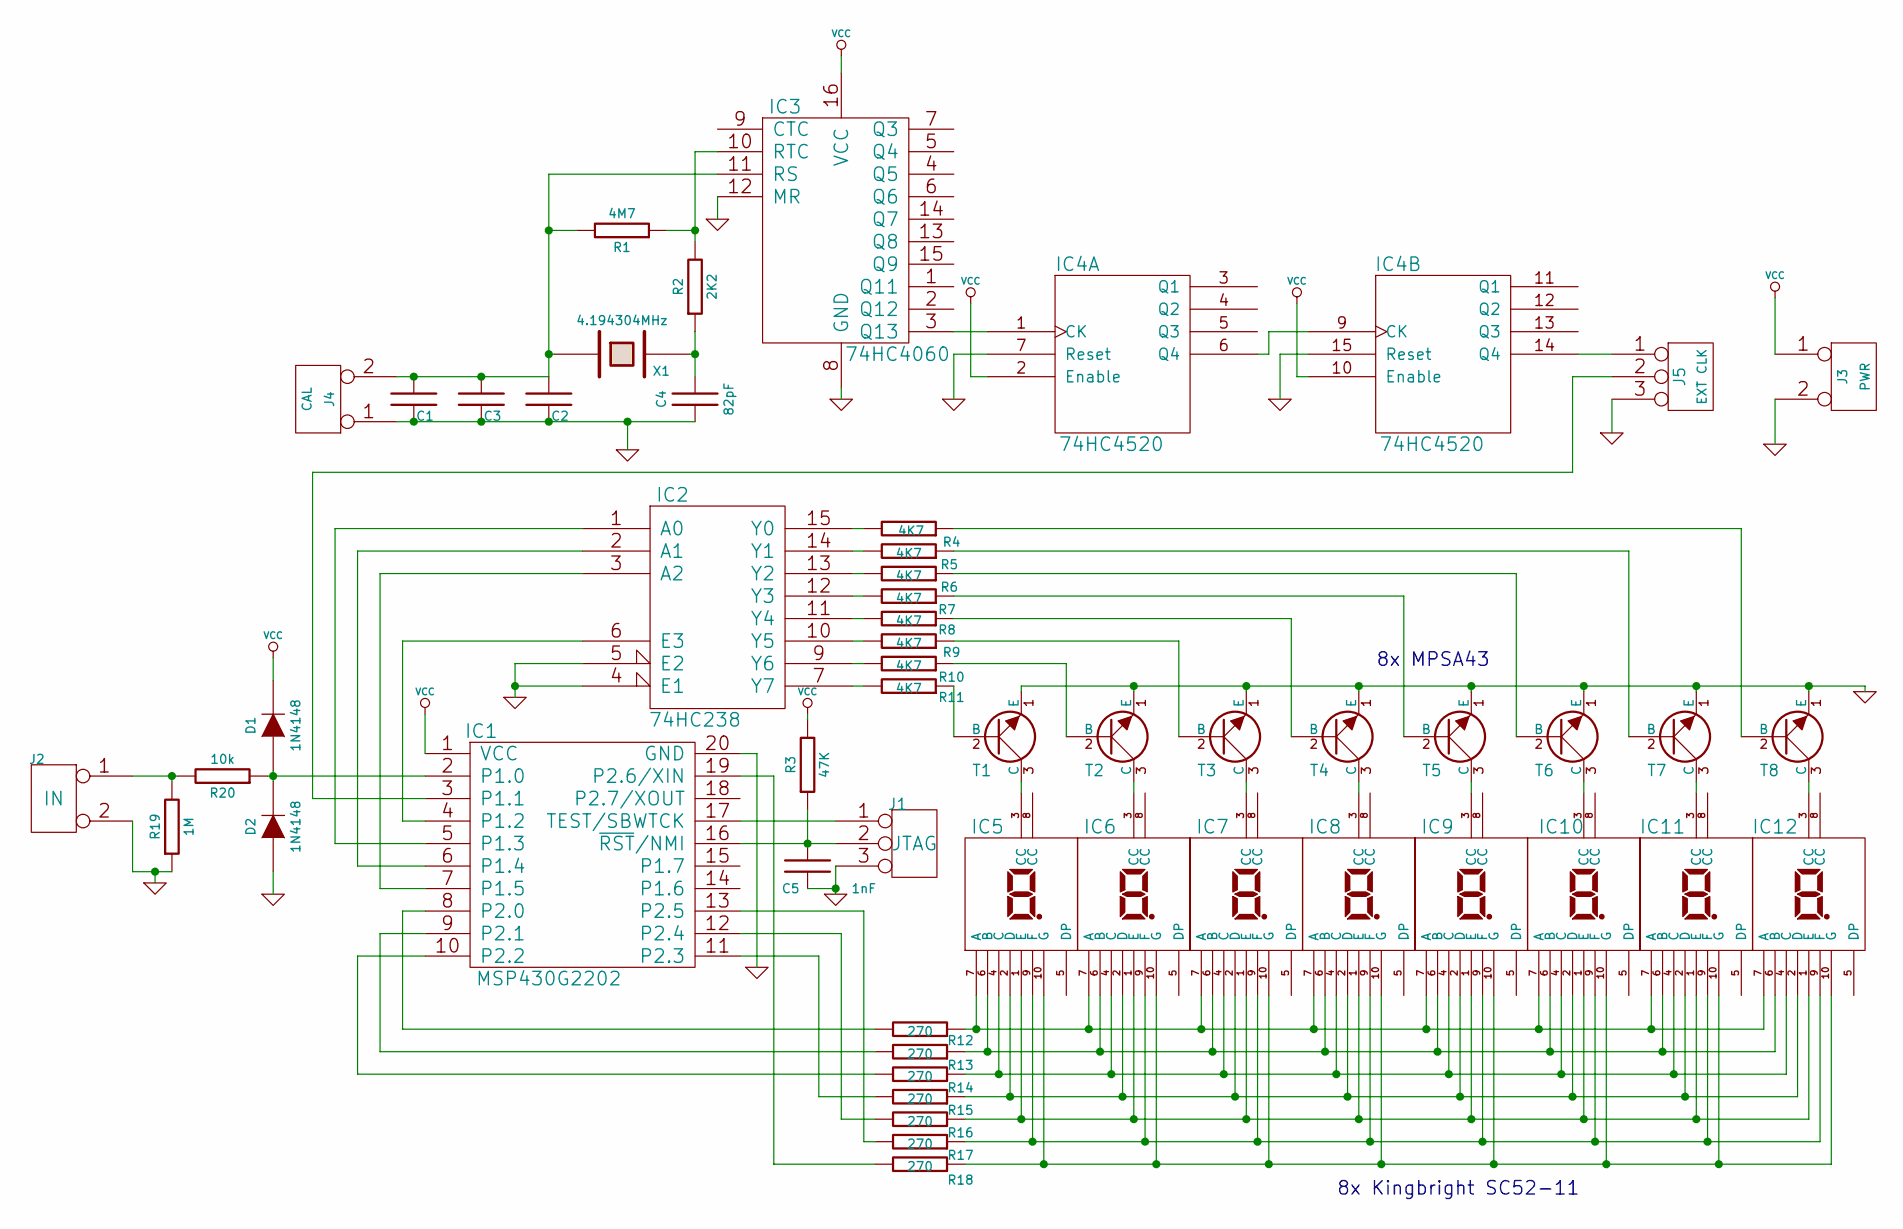
[picture p24: schematic FC002B.sch]

Parts:
C1, C2, C3: C; C1
C4: 82pF; C1
C5: 1nF; C1
D1, D2: 1N4148; D3
IC1: MSP430G2202; DIP-20__300_ELL
IC2: 74HC238; DIP-16__300_ELL
IC3: 74HC4060; DIP-16__300_ELL
IC4: 74HC4520; DIP-16__300_ELL
IC5, IC6, IC7, IC8, IC9, IC10, IC11, IC12: SC52-11; Kingbright SC52-11
J1: JTAG; SIL-3-1
J2: IN; SIL-2
J3: PWR; SIL-2
J4: CAL; SIL-2
J5: EXT CLK; SIL-3-1
R1: 4M7; R4-SP
R2: 2K2; R4-SP
R3: 47K; R4-SP
R4, R5, R6, R7, R8, R9, R10, R11: 4K7; R4-SP
R12, R13, R14, R15, R16, R17, R18: 270; R4-SP
R19: 1M; R4
R20: 10k; R4
T1, T2, T3, T4, T5, T6, T7, T8: MPSA43; TO-92_LIN
X1: 4.194304MHz; XTAL_MHz

Connections:
GND: C1.2, C2.2, C3.2, C4.2, C5.2, D2.1 (A), IC1.20 (GND), IC2.4 (E1), IC2.5 (E2), IC3.8 (GND), IC3.12 (MR), IC4.7 (Reset), IC4.15 (Reset), J1.3, J2.2 (PM), J3.2 (PM), J4.1, J5.3, R19.2, T1.1 (E), T2.1 (E), T3.1 (E), T4.1 (E), T5.1 (E), T6.1 (E), T7.1 (E), T8.1 (E)
unnamed: C1.1, C2.1, C3.1, IC3.11 (RS), J4.2 (PM), R1.1, X1.1
unnamed: C4.1, R2.2, X1.2
unnamed: C5.1, IC1.16 (~RST~/NMI), J1.2 (PM), R3.2
unnamed: D1.1 (A), D2.2 (K), IC1.2 (P1.0), R20.2
unnamed: IC1.3 (P1.1), J5.2 (PM)
unnamed: IC1.4 (P1.2), IC2.6 (E3)
unnamed: IC1.5 (P1.3), IC2.1 (A0)
unnamed: IC1.6 (P1.4), IC2.2 (A1)
unnamed: IC1.7 (P1.5), IC2.3 (A2)
unnamed: IC1.8 (P2.0), R12.1
unnamed: IC1.9 (P2.1), R13.1
unnamed: IC1.10 (P2.2), R14.1
unnamed: IC1.11 (P2.3), R15.1
unnamed: IC1.12 (P2.4), R16.1
unnamed: IC1.13 (P2.5), R17.1
unnamed: IC1.17 (TEST/SBWTCK), J1.1
unnamed: IC1.19 (P2.6/XIN), R18.1
unnamed: IC2.7 (Y7), R11.1
unnamed: IC2.9 (Y6), R10.1
unnamed: IC2.10 (Y5), R9.1
unnamed: IC2.11 (Y4), R8.1
unnamed: IC2.12 (Y3), R7.1
unnamed: IC2.13 (Y2), R6.1
unnamed: IC2.14 (Y1), R5.1
unnamed: IC2.15 (Y0), R4.1
unnamed: IC3.3 (Q13), IC4.1 (CK)
unnamed: IC3.10 (RTC), R1.2, R2.1
unnamed: IC4.6 (Q4), IC4.9 (CK)
unnamed: IC4.14 (Q4), J5.1
unnamed: IC5.3 (CC), T1.3 (C)
unnamed: IC6.3 (CC), T2.3 (C)
unnamed: IC7.3 (CC), T3.3 (C)
unnamed: IC8.3 (CC), T4.3 (C)
unnamed: IC9.3 (CC), T5.3 (C)
unnamed: IC5.1 (E), IC6.1 (E), IC7.1 (E), IC8.1 (E), IC9.1 (E), IC10.1 (E), IC11.1 (E), IC12.1 (E), R16.2
unnamed: IC5.2 (D), IC6.2 (D), IC7.2 (D), IC8.2 (D), IC9.2 (D), IC10.2 (D), IC11.2 (D), IC12.2 (D), R15.2
unnamed: IC10.3 (CC), T6.3 (C)
unnamed: IC5.4 (C), IC6.4 (C), IC7.4 (C), IC8.4 (C), IC9.4 (C), IC10.4 (C), IC11.4 (C), IC12.4 (C), R14.2
unnamed: IC5.6 (B), IC6.6 (B), IC7.6 (B), IC8.6 (B), IC9.6 (B), IC10.6 (B), IC11.6 (B), IC12.6 (B), R13.2
unnamed: IC5.7 (A), IC6.7 (A), IC7.7 (A), IC8.7 (A), IC9.7 (A), IC10.7 (A), IC11.7 (A), IC12.7 (A), R12.2
unnamed: IC5.9 (F), IC6.9 (F), IC7.9 (F), IC8.9 (F), IC9.9 (F), IC10.9 (F), IC11.9 (F), IC12.9 (F), R17.2
unnamed: IC5.10 (G), IC6.10 (G), IC7.10 (G), IC8.10 (G), IC9.10 (G), IC10.10 (G), IC11.10 (G), IC12.10 (G), R18.2
unnamed: IC11.3 (CC), T7.3 (C)
unnamed: IC12.3 (CC), T8.3 (C)
unnamed: J2.1, R19.1, R20.1
unnamed: R4.2, T8.2 (B)
unnamed: R5.2, T7.2 (B)
unnamed: R6.2, T6.2 (B)
unnamed: R7.2, T5.2 (B)
unnamed: R8.2, T4.2 (B)
unnamed: R9.2, T3.2 (B)
unnamed: R10.2, T2.2 (B)
unnamed: R11.2, T1.2 (B)
VCC: D1.2 (K), IC1.1 (VCC), IC3.16 (VCC), IC4.2 (Enable), IC4.10 (Enable), J3.1, R3.1

Notes on the sheet:
8x MPSA43
8x Kingbright SC52-11
