sufzoli/suf-electronics-fc002/FC003 (Home PCB)/KiCAD/FC003.sch

## KiCad design FC003 (Home PCB)/KiCAD/FC003.sch (2014-01-09)

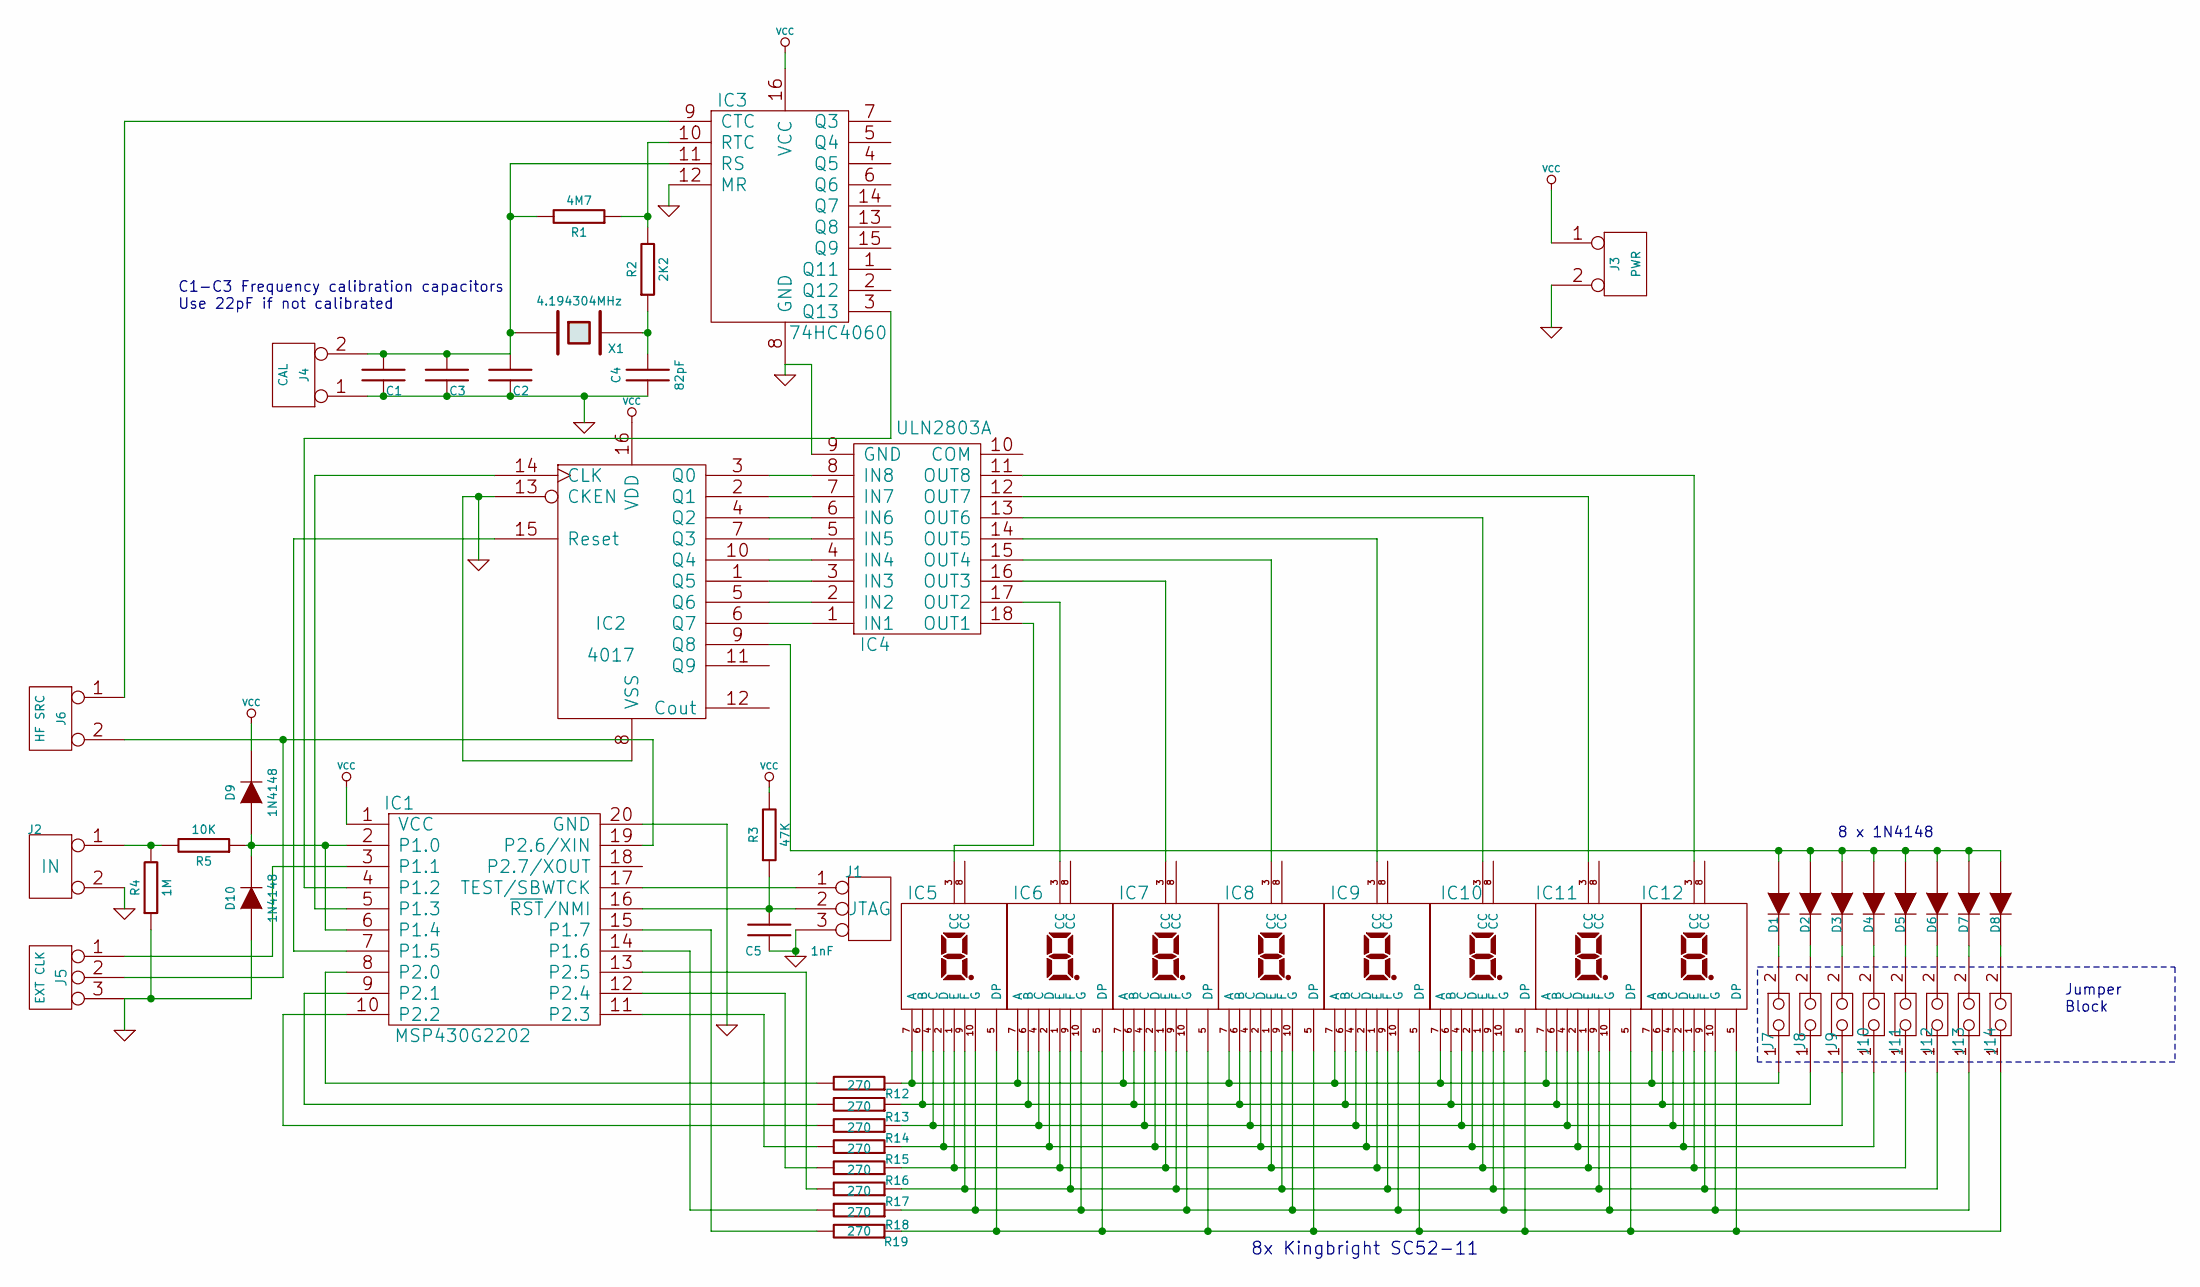
[picture p25: schematic FC003.sch]

Parts:
C1, C2, C3: C; C1
C4: 82pF; C1
C5: 1nF; C1
D1, D2, D3, D4, D5, D6, D7, D8: D3
D9, D10: 1N4148; D3
IC1: MSP430G2202; DIP-20__300_ELL
IC2: 4017; DIP-16__300_ELL
IC3: 74HC4060; DIP-16__300_ELL
IC4: ULN2803A; DIP-18__300_ELL
IC5, IC6, IC7, IC8, IC9, IC10, IC11, IC12: SC52-11; Kingbright_SC52-11
J1: JTAG; SIL-3-1
J2: IN; SIL-2
J3: PWR; SIL-2
J4: CAL; SIL-2
J5: EXT CLK; SIL-3-1
J6: HF SRC; SIL-2
J7, J8, J9, J10, J11, J12, J13, J14: SIL-2
R1: 4M7; R4-SP
R2: 2K2; R4-SP
R3: 47K; R4-SP
R4: 1M; R4
R5: 10K; R4
R12, R13, R14, R15, R16, R17, R18, R19: 270; R4-SP
X1: 4.194304MHz; XTAL_MHz

Connections:
GND: C1.2, C2.2, C3.2, C4.2, C5.2, D10.1 (A), IC1.20 (GND), IC2.8 (VSS), IC2.13 (CKEN), IC3.8 (GND), IC3.12 (MR), IC4.9 (GND), J1.3, J2.2 (PM), J3.2 (PM), J4.1, J5.3, R4.2
unnamed: C1.1, C2.1, C3.1, IC3.11 (RS), J4.2 (PM), R1.1, X1.1
unnamed: C4.1, R2.2, X1.2
unnamed: C5.1, IC1.16 (~RST~/NMI), J1.2 (PM), R3.2
unnamed: D1.1 (A), D2.1 (A), D3.1 (A), D4.1 (A), D5.1 (A), D6.1 (A), D7.1 (A), D8.1 (A), IC2.9 (Q8)
unnamed: D1.2 (K), J7.2
unnamed: D2.2 (K), J8.2
unnamed: D3.2 (K), J9.2
unnamed: D4.2 (K), J10.2
unnamed: D5.2 (K), J11.2
unnamed: D6.2 (K), J12.2
unnamed: D7.2 (K), J13.2
unnamed: D8.2 (K), J14.2
unnamed: D9.1 (A), D10.2 (K), IC1.2 (P1.0), IC1.6 (P1.4), R5.2
unnamed: IC1.3 (P1.1), J5.1
unnamed: IC1.4 (P1.2), IC3.3 (Q13)
unnamed: IC1.5 (P1.3), IC2.14 (CLK)
unnamed: IC1.7 (P1.5), IC2.15 (Reset)
unnamed: IC1.8 (P2.0), R12.1
unnamed: IC1.9 (P2.1), R13.1
unnamed: IC1.10 (P2.2), R14.1
unnamed: IC1.11 (P2.3), R15.1
unnamed: IC1.12 (P2.4), R16.1
unnamed: IC1.13 (P2.5), R17.1
unnamed: IC1.14 (P1.6), R18.1
unnamed: IC1.15 (P1.7), R19.1
unnamed: IC1.17 (TEST/SBWTCK), J1.1
unnamed: IC1.19 (P2.6/XIN), J5.2 (PM), J6.2 (PM)
unnamed: IC2.1 (Q5), IC4.3 (IN3)
unnamed: IC2.2 (Q1), IC4.7 (IN7)
unnamed: IC2.3 (Q0), IC4.8 (IN8)
unnamed: IC2.4 (Q2), IC4.6 (IN6)
unnamed: IC2.5 (Q6), IC4.2 (IN2)
unnamed: IC2.6 (Q7), IC4.1 (IN1)
unnamed: IC2.7 (Q3), IC4.5 (IN5)
unnamed: IC2.10 (Q4), IC4.4 (IN4)
unnamed: IC3.9 (CTC), J6.1
unnamed: IC3.10 (RTC), R1.2, R2.1
unnamed: IC4.14 (OUT5), IC9.3 (CC)
unnamed: IC4.15 (OUT4), IC8.3 (CC)
unnamed: IC4.16 (OUT3), IC7.3 (CC)
unnamed: IC4.17 (OUT2), IC6.3 (CC)
unnamed: IC4.18 (OUT1), IC5.3 (CC)
unnamed: IC5.1 (E), IC6.1 (E), IC7.1 (E), IC8.1 (E), IC9.1 (E), IC10.1 (E), IC11.1 (E), IC12.1 (E), J11.1, R16.2
unnamed: IC5.2 (D), IC6.2 (D), IC7.2 (D), IC8.2 (D), IC9.2 (D), IC10.2 (D), IC11.2 (D), IC12.2 (D), J10.1, R15.2
unnamed: IC4.13 (OUT6), IC10.3 (CC)
unnamed: IC5.4 (C), IC6.4 (C), IC7.4 (C), IC8.4 (C), IC9.4 (C), IC10.4 (C), IC11.4 (C), IC12.4 (C), J9.1, R14.2
unnamed: IC5.5 (DP), IC6.5 (DP), IC7.5 (DP), IC8.5 (DP), IC9.5 (DP), IC10.5 (DP), IC11.5 (DP), IC12.5 (DP), J14.1, R19.2
unnamed: IC5.6 (B), IC6.6 (B), IC7.6 (B), IC8.6 (B), IC9.6 (B), IC10.6 (B), IC11.6 (B), IC12.6 (B), J8.1, R13.2
unnamed: IC5.7 (A), IC6.7 (A), IC7.7 (A), IC8.7 (A), IC9.7 (A), IC10.7 (A), IC11.7 (A), IC12.7 (A), J7.1, R12.2
unnamed: IC5.9 (F), IC6.9 (F), IC7.9 (F), IC8.9 (F), IC9.9 (F), IC10.9 (F), IC11.9 (F), IC12.9 (F), J12.1, R17.2
unnamed: IC5.10 (G), IC6.10 (G), IC7.10 (G), IC8.10 (G), IC9.10 (G), IC10.10 (G), IC11.10 (G), IC12.10 (G), J13.1, R18.2
unnamed: IC4.12 (OUT7), IC11.3 (CC)
unnamed: IC4.11 (OUT8), IC12.3 (CC)
unnamed: J2.1, R4.1, R5.1
VCC: D9.2 (K), IC1.1 (VCC), IC2.16 (VDD), IC3.16 (VCC), J3.1, R3.1

Notes on the sheet:
C1-C3 Frequency calibration capacitors Use 22pF if not calibrated
8x Kingbright SC52-11
8 x 1N4148
Jumper Block
