sufzoli/suf-electronics-fc002/(commit log)

2013-08-05 Additions for the RT 2013/09 article
    [FC002B.brd]
2013-08-22 Changed the digit driver resistors to 4,7k
    [FC002B.csv, FC002B.sch, FC002B_BOM.xlsx]
2013-11-13 Added a new software fork for time period based measurement FC002OPT_G2202+LF
    [FC002B.brd, FC002B.sch]
2013-12-02 FC003 Added
    [FC003.sch]
2013-12-03 F003 Schematic 20131202_1
    [FC003.sch]
2013-12-03 FC003 - Schematic 20131203_2
    [FC003.sch]
2014-01-09 FC003 - Hardware bugfix The polarity of the mode select diodes changed the software changed according to the hardware change The schematic improved for the better readability
    [FC003.brd, FC003.sch]
2014-01-12 Hardware - FC003 (Home PCB) - moved to a separate folder - FC002B (Production PCB) - first design added
    [FC003.brd, FC003.kicad_pcb, FC003.sch, FC003_print.kicad_pcb]
2014-01-13 FC003 (Production PCB) - intermittent changes
    [FC003.kicad_pcb]
2014-01-17 Hardware Design finished Casing (SOB) added design/caes panelize added
    [FC003.kicad_pcb, FC003.sch, FC003_SOB.kicad_pcb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]
2014-01-21 Hardware: Minor PCB modifications SOB manufacturing plans
    [FC003.kicad_pcb, FC003_SOB-Edge_Cuts.dxf]
2014-01-21 Hardware: SOB - Error correction for manufacturing
    [FC003_SOB-Edge_Cuts.dxf, FC003_SOB.kicad_pcb]
2014-01-22 Hardware FC003 panelize + gerber
    [FC003.gbl, FC003.gbo, FC003.gbs, FC003.gtl, FC003.gts]
2014-02-06 Cost calculation added
    [FC003.sch, FC003_cost.xlsx]
2014-02-07 Documentation/FC003-Proto-conn.jpg - Added: picture with the connector description Software Added bare counting Added fill factor measurement
2014-02-07 FC003 home pcb one page documentation added
2014-02-11 FC003 Documentation changes
    [FC003_cost.xlsx]
2014-03-05 FC003 Software: Changed the switch behavior to correspond to the production panel's switch organization
2014-03-13 Added startup message bugfixes
    [main.c, textconv.c, textconv.h]
2014-03-20 FC003 Software: Changed display handling - corrected the missing display if the value less then 1 and leading zero switched off
    [main.c, textconv.c, textconv.h]
2014-10-11 FC003 template for accessories FC003 Imput amplifier accessory added
    [FC003_Input.kicad_pcb, FC003_Input.sch, FC003_template.kicad_pcb]
2021-03-20 Add doc v0.3
    [FC003.sch]
